johangroth/pluto2/HW/pluto.pdf

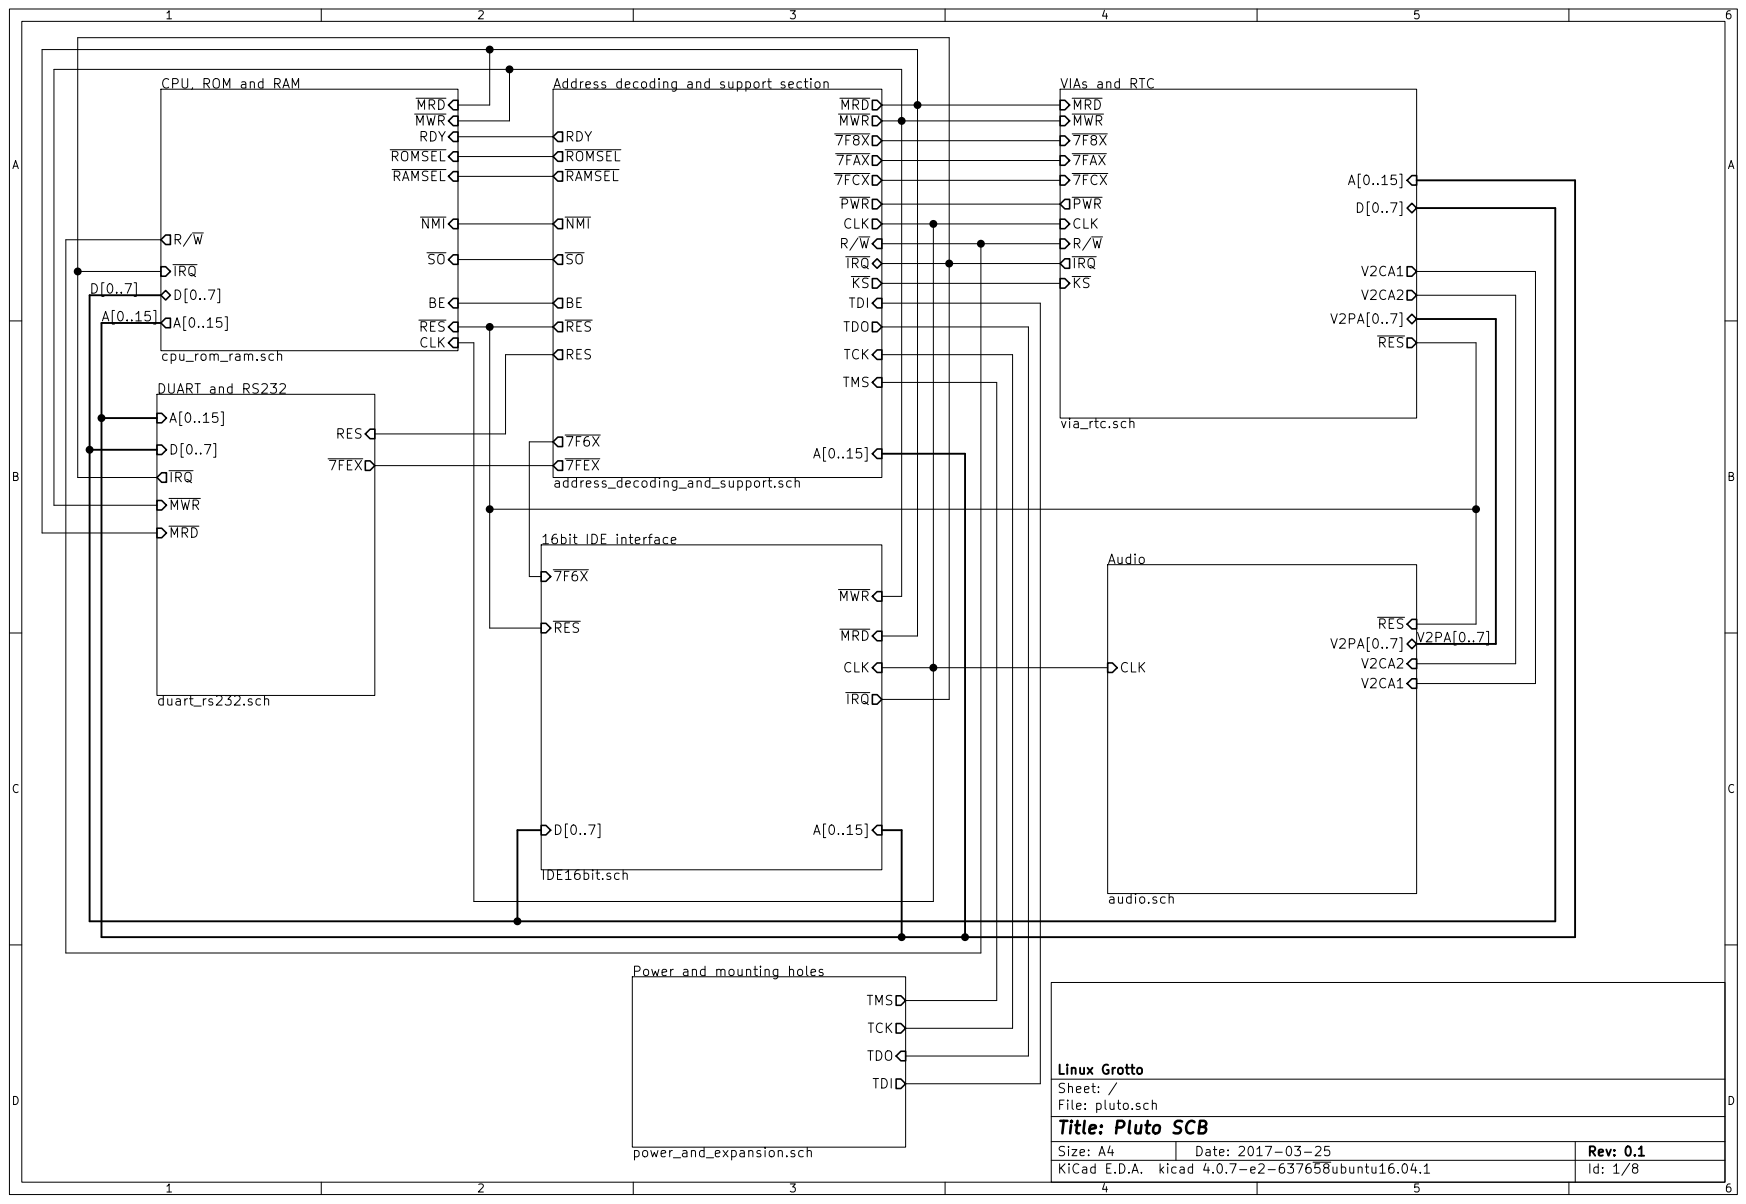
[picture p12: page 1]

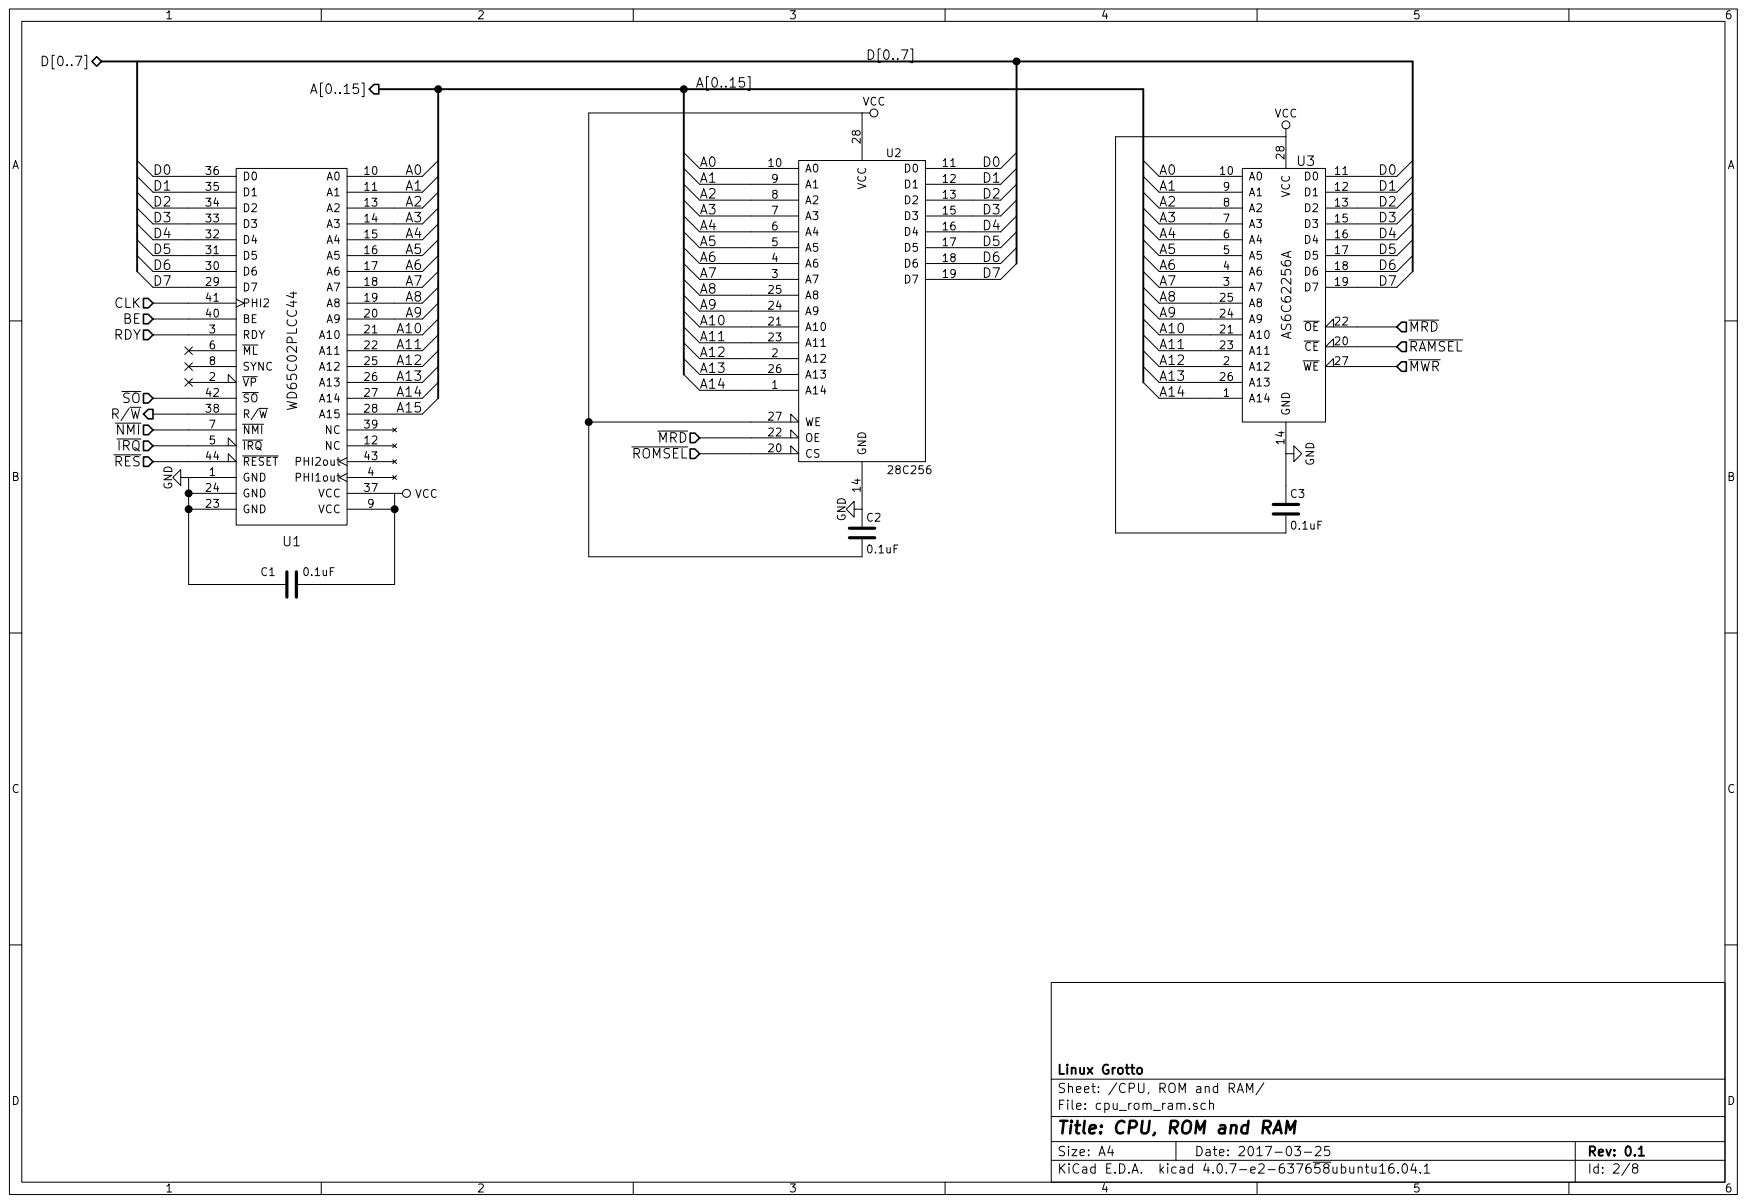
[picture p13: page 2]

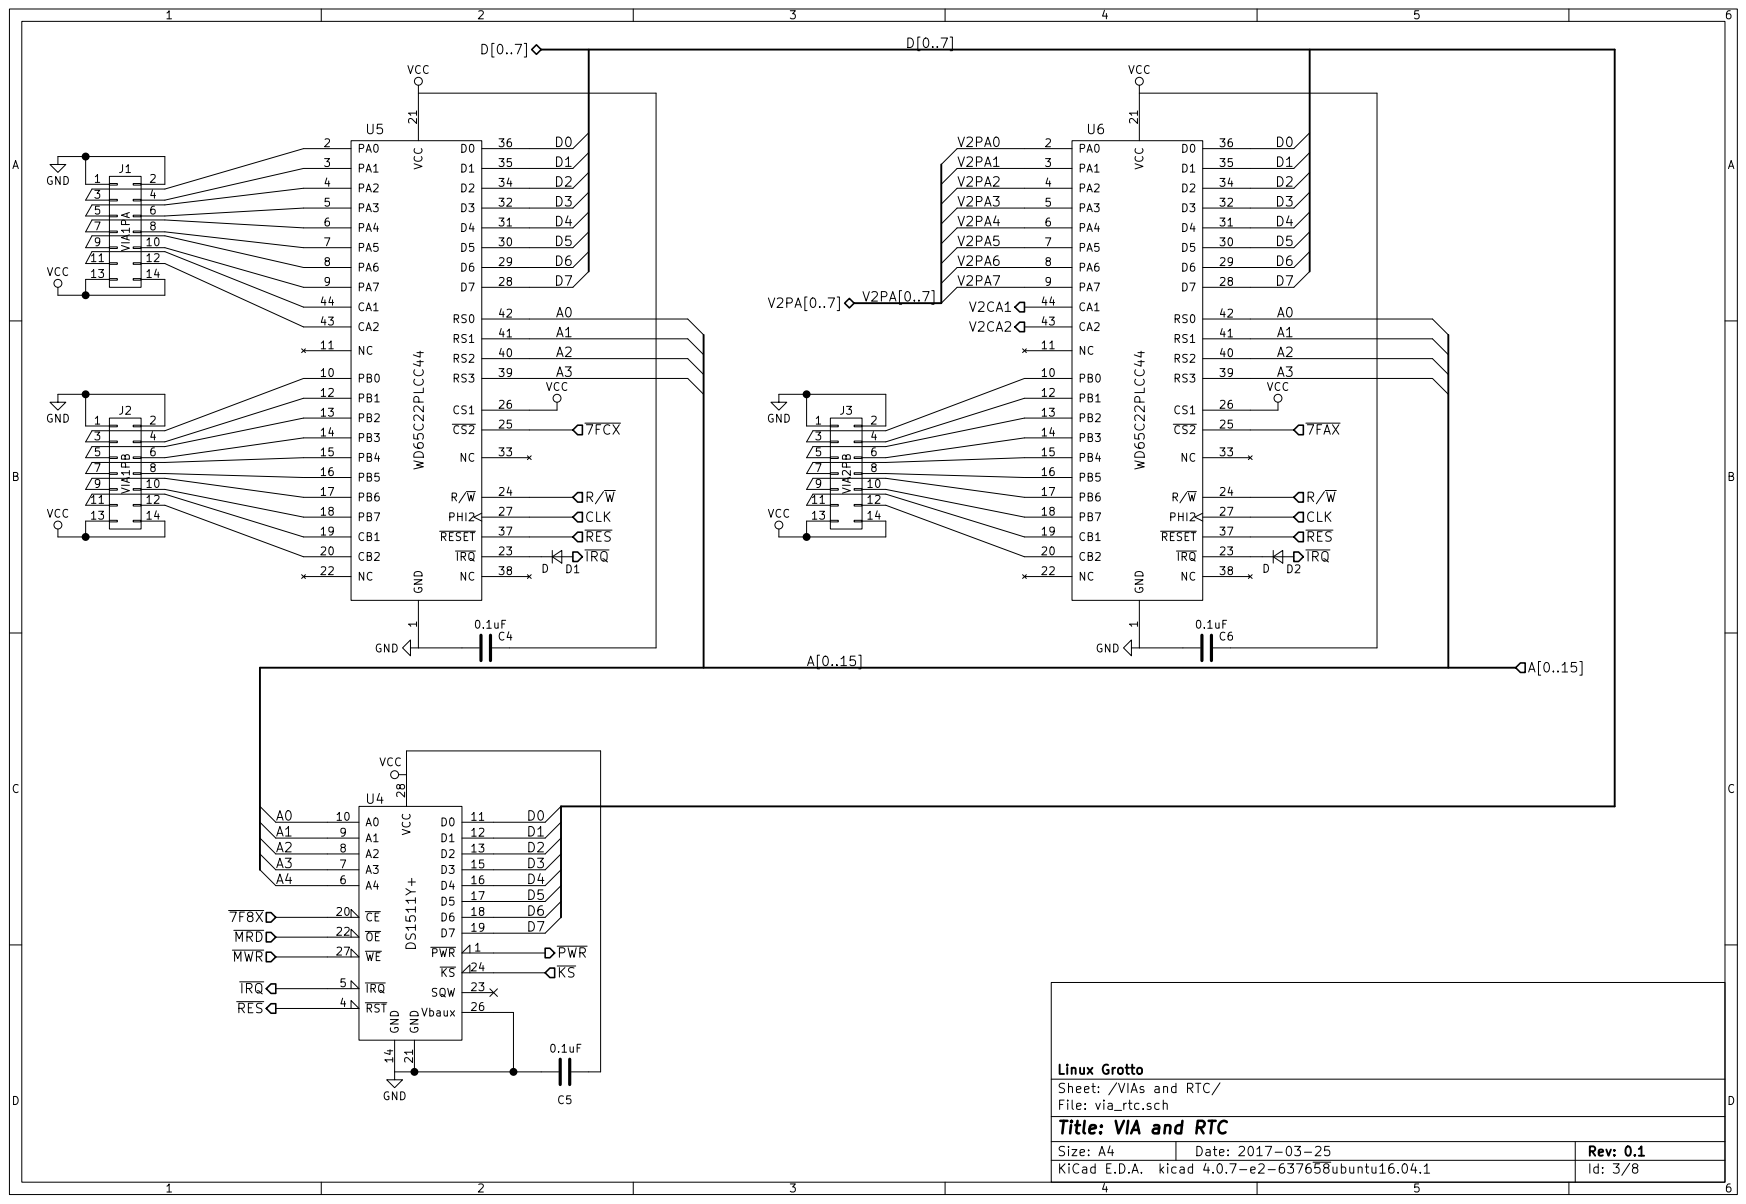
[picture p14: page 3]

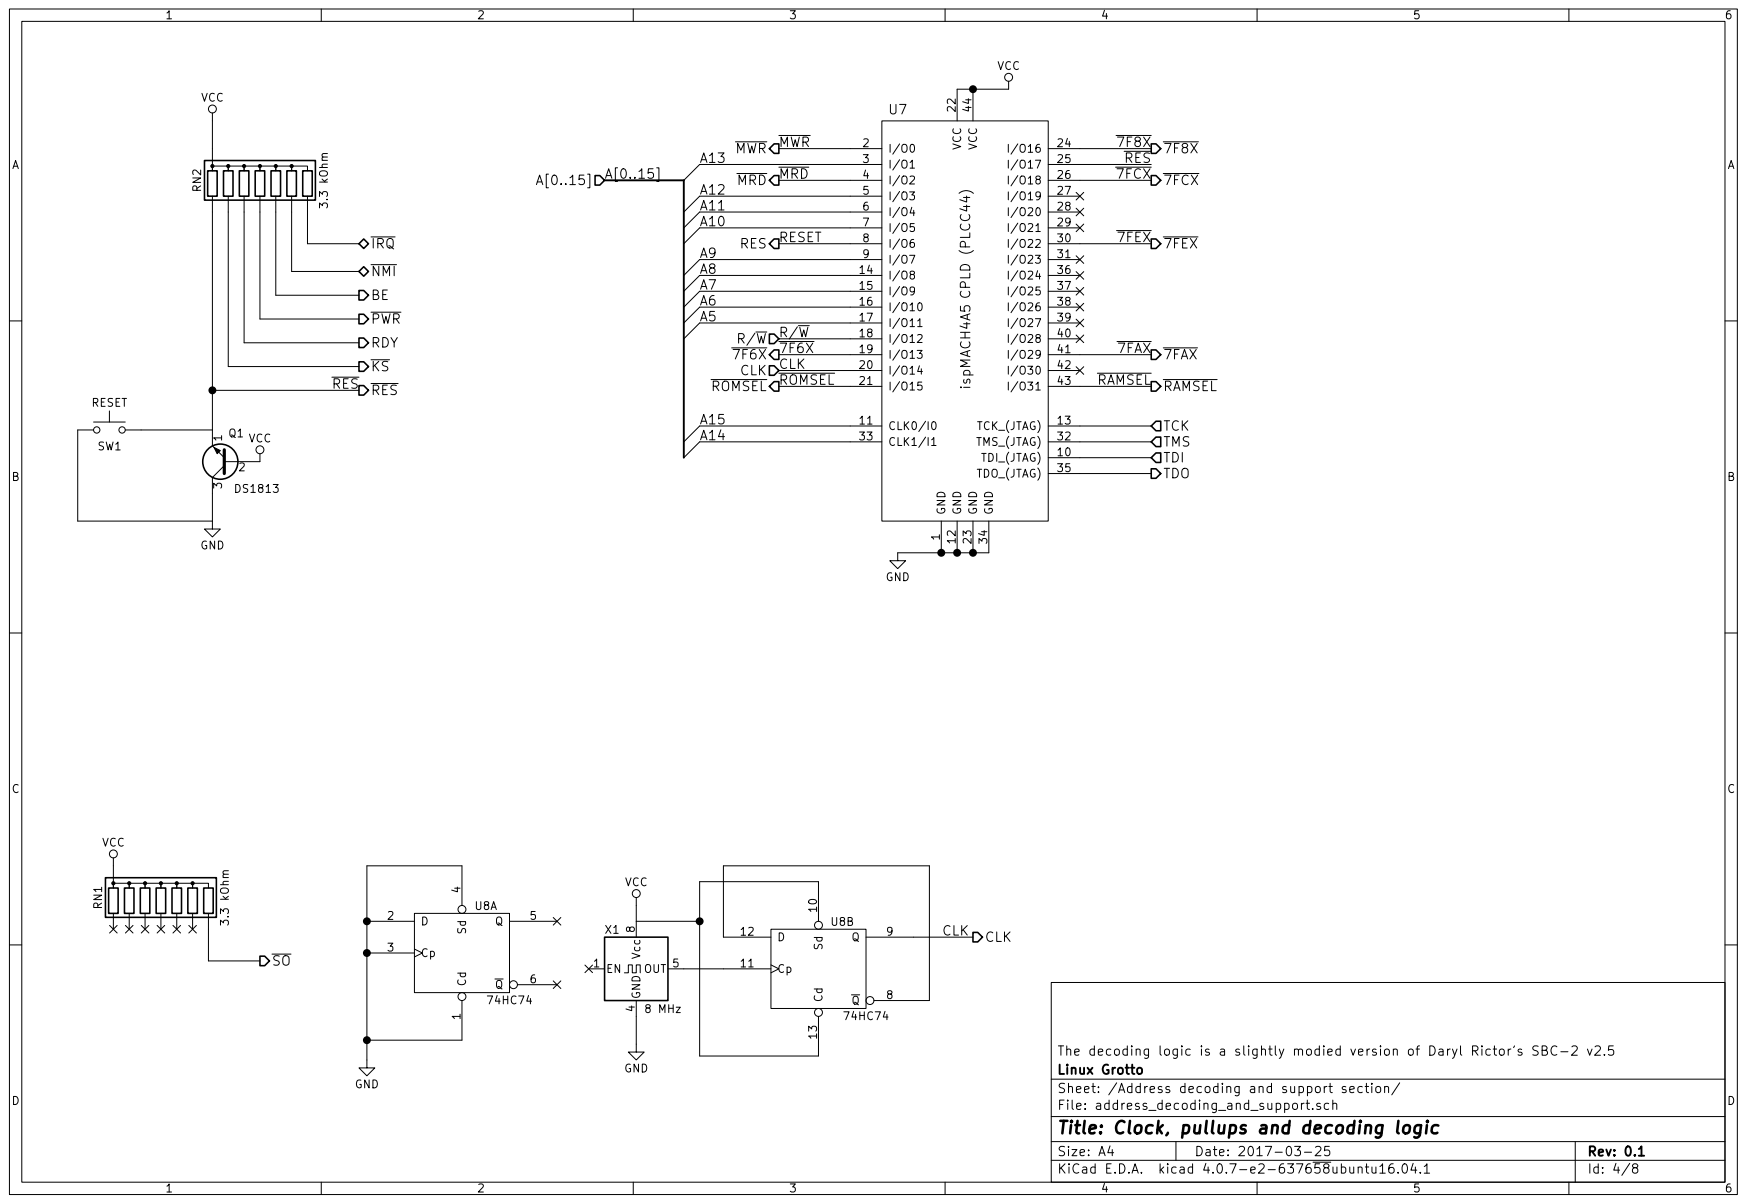
[picture p15: page 4]

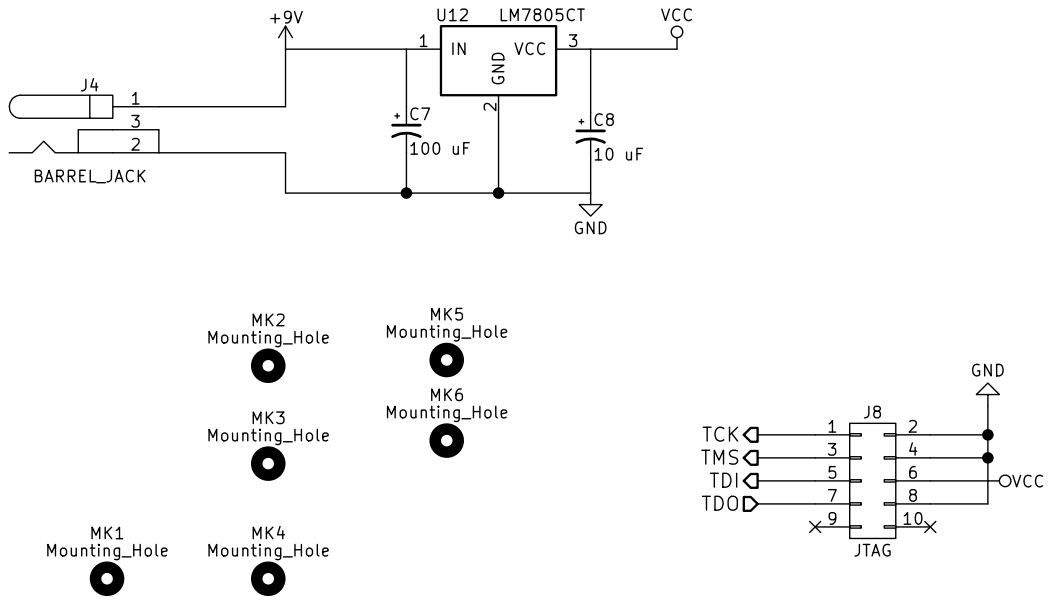
[picture p16: page 5]

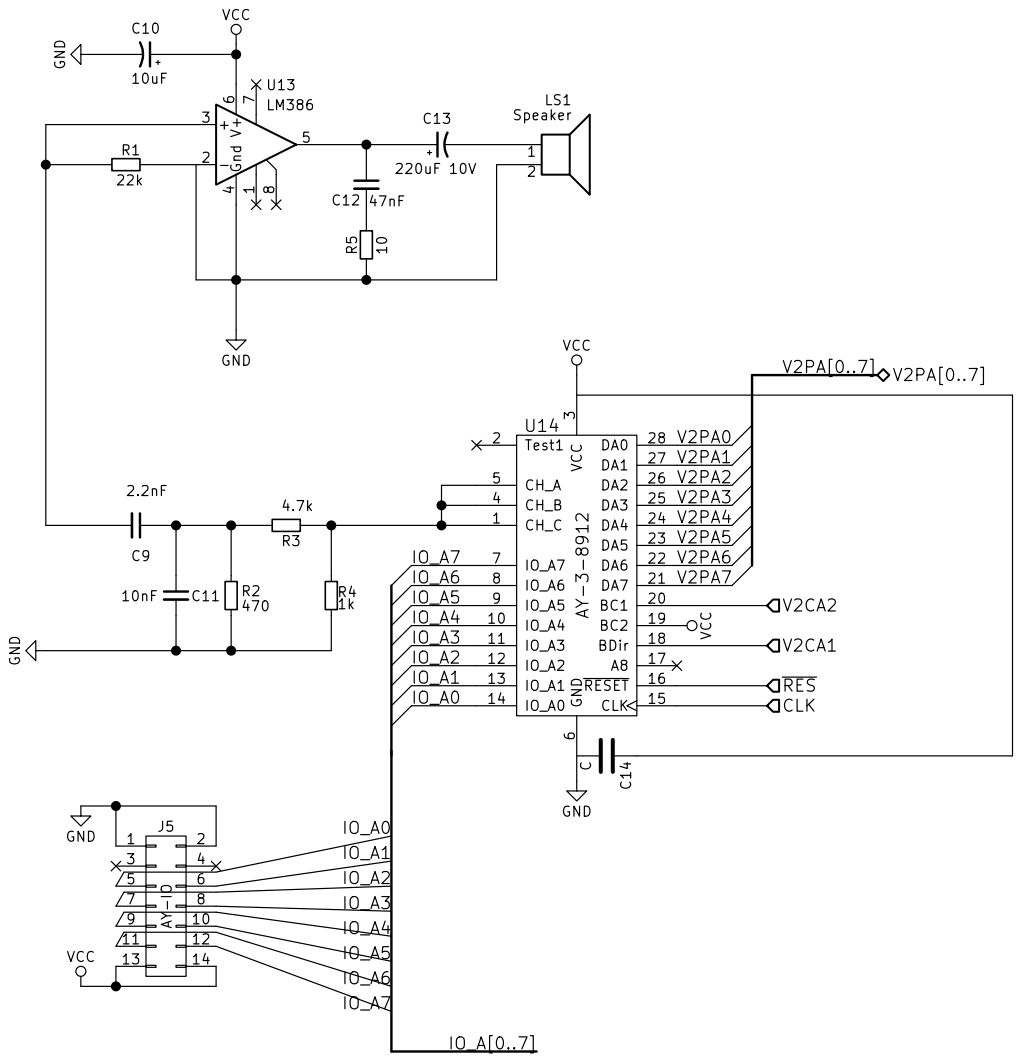
[picture p17: page 6]

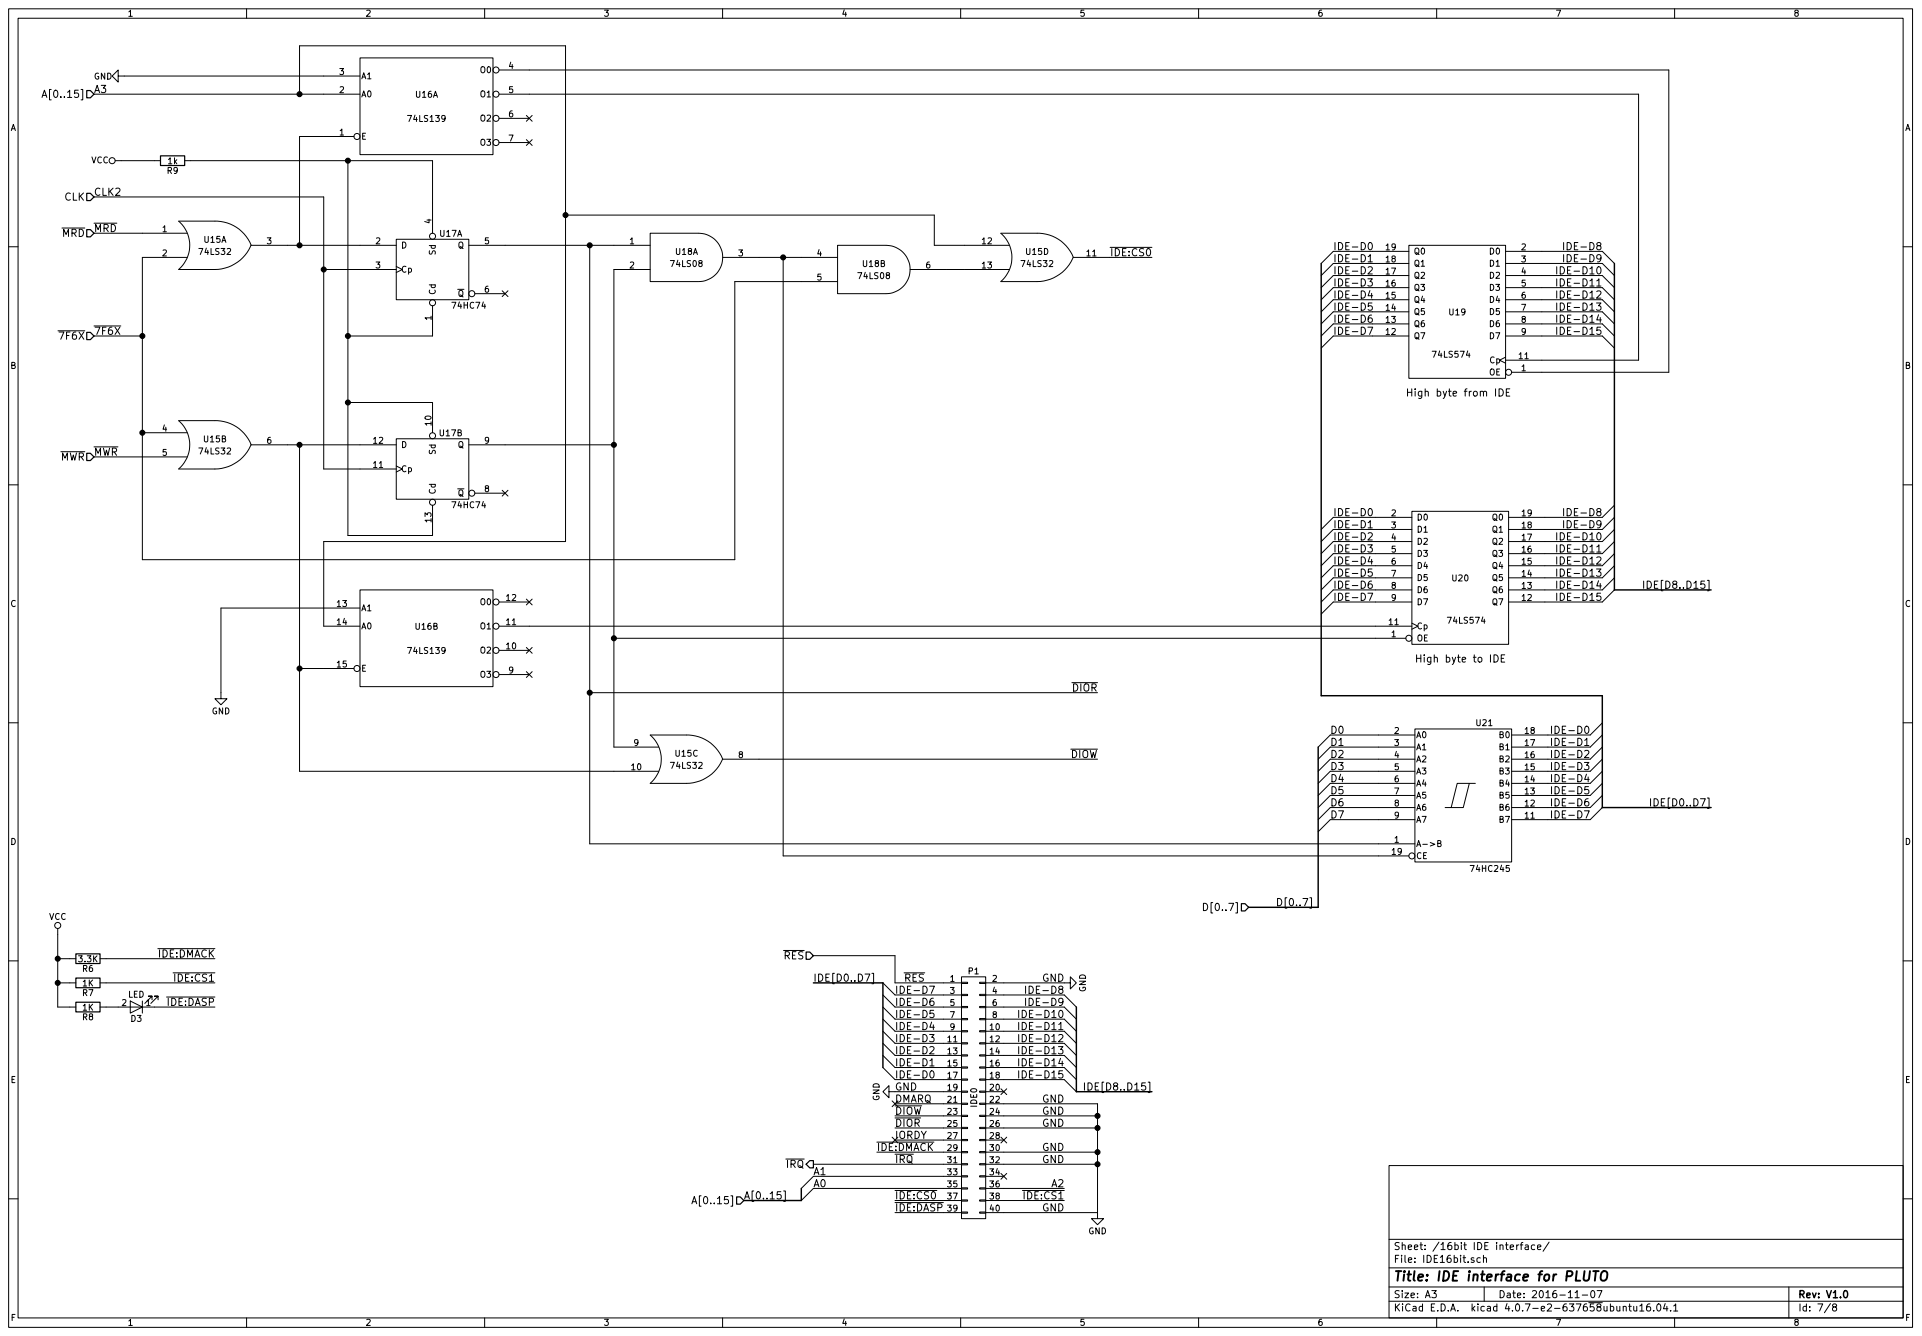
[picture p18: page 7]

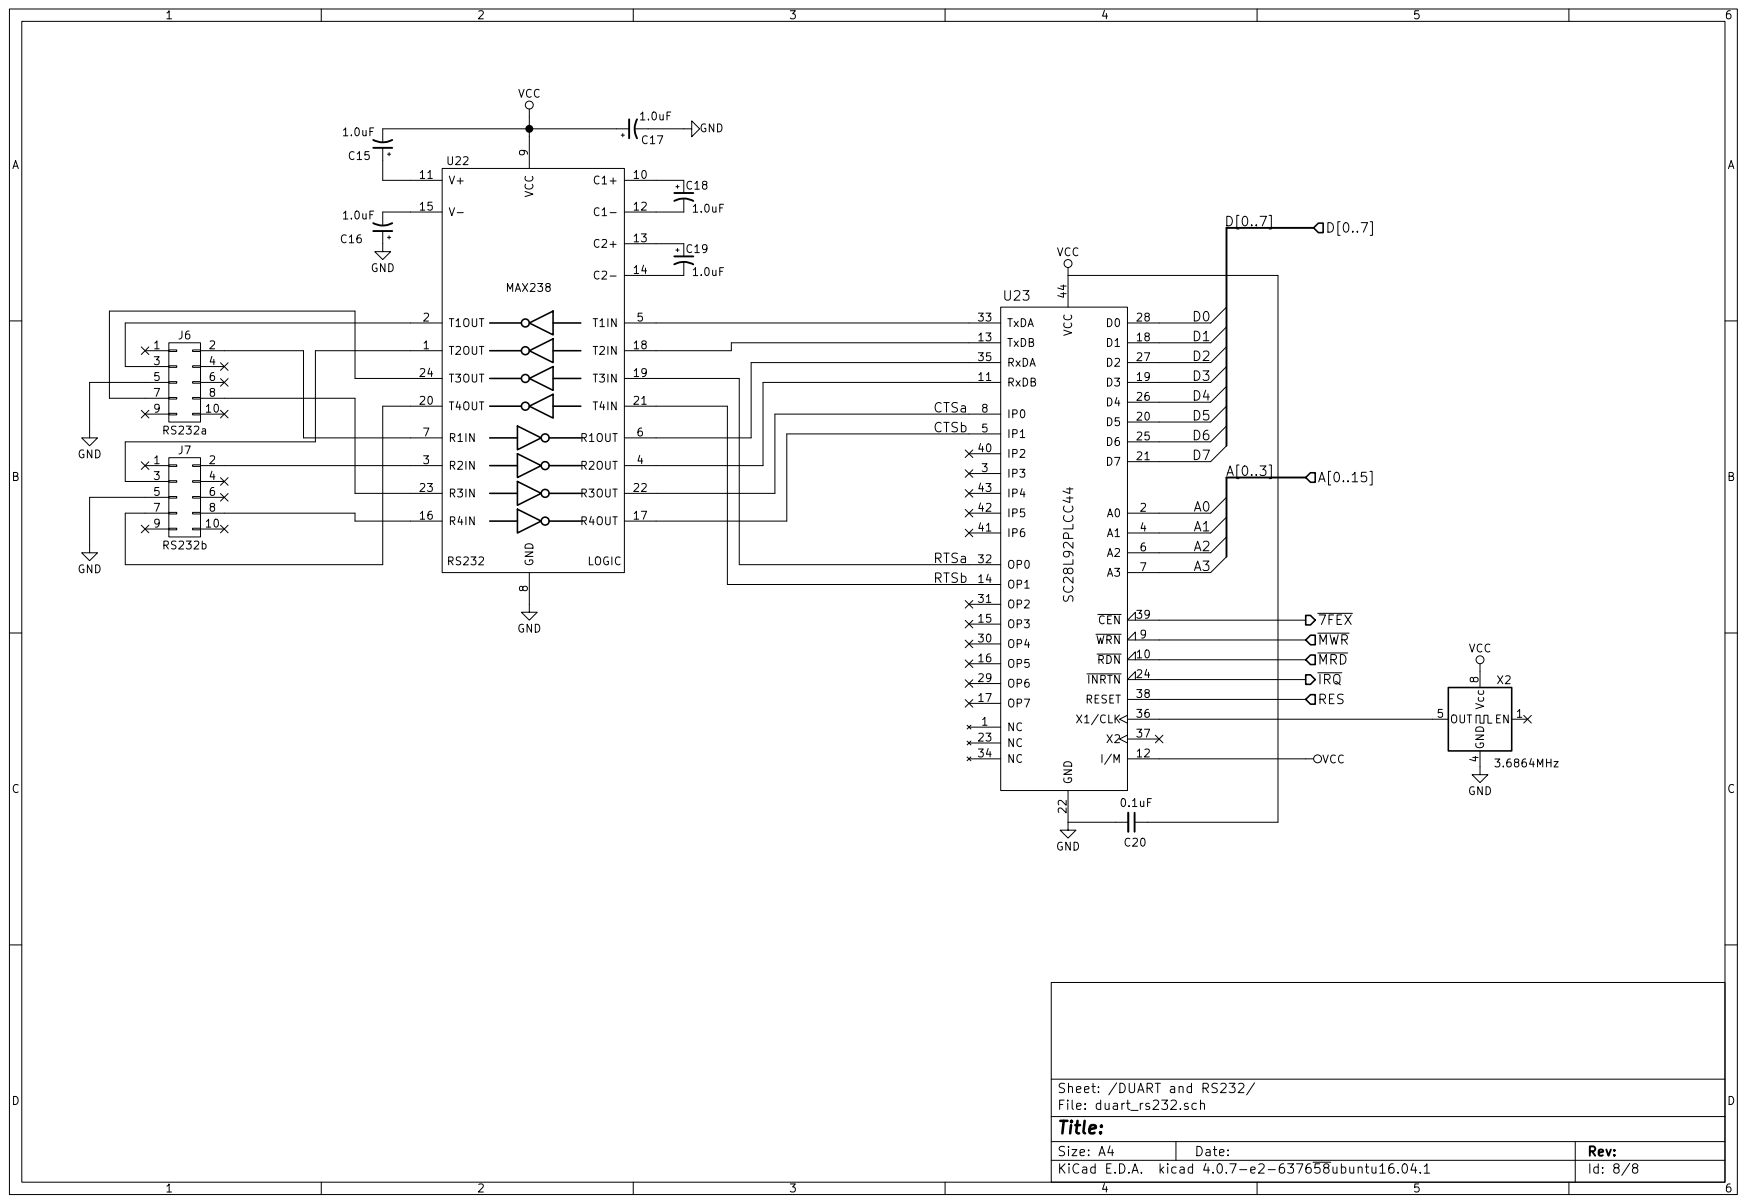
[picture p19: page 8]
