johangroth/pluto2/(list of files, drawings)

Other design files:
HW/pluto.dsn
