johangroth/pluto2/HW/pluto.kicad_pcb

## KiCad design HW/pluto.kicad_pcb (2019-11-03)

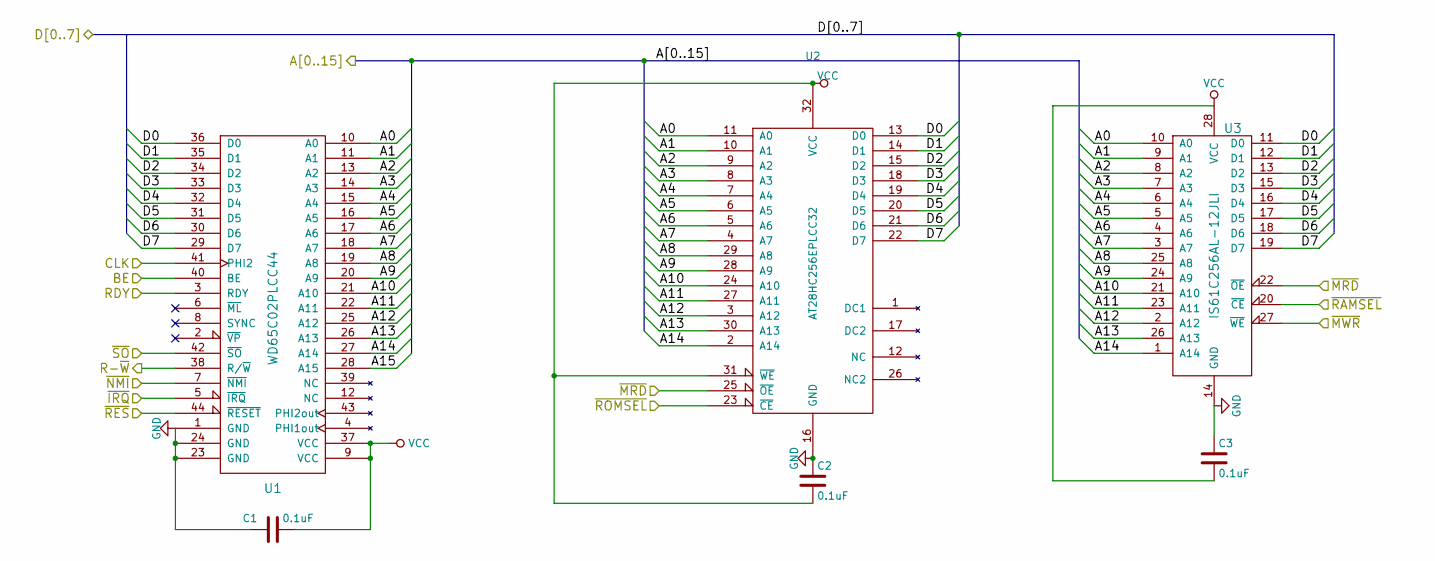
[picture p20: schematic cpu_rom_ram.sch, CPU, ROM and RAM]

Parts:
C1, C2, C3: 0.1uF; C_0805_2012Metric_Pad1.15x1.40mm_HandSolder
U1: WD65C02PLCC44; PLCC-44_THT-Socket
U2: AT28HC256EPLCC32; PLCC-32_THT-Socket
U3: IS61C256AL-12JLI; SOJ-28_7.585x18.12mm_P1.27mm

Connections:
/16bit IDE interface/A0: U1.10 (A0), U2.11 (A0), U3.10 (A0); also elsewhere on the board
/16bit IDE interface/A1: U1.11 (A1), U2.10 (A1), U3.9 (A1); also elsewhere on the board
/16bit IDE interface/A2: U1.13 (A2), U2.9 (A2), U3.8 (A2); also elsewhere on the board
/16bit IDE interface/A3: U1.14 (A3), U2.8 (A3), U3.7 (A3); also elsewhere on the board
/16bit IDE interface/CLK: U1.41 (PHI2); also elsewhere on the board
/16bit IDE interface/D0: U1.36 (D0), U2.13 (D0), U3.11 (D0); also elsewhere on the board
/16bit IDE interface/D1: U1.35 (D1), U2.14 (D1), U3.12 (D1); also elsewhere on the board
/16bit IDE interface/D2: U1.34 (D2), U2.15 (D2), U3.13 (D2); also elsewhere on the board
/16bit IDE interface/D3: U1.33 (D3), U2.18 (D3), U3.15 (D3); also elsewhere on the board
/16bit IDE interface/D4: U1.32 (D4), U2.19 (D4), U3.16 (D4); also elsewhere on the board
/16bit IDE interface/D5: U1.31 (D5), U2.20 (D5), U3.17 (D5); also elsewhere on the board
/16bit IDE interface/D6: U1.30 (D6), U2.21 (D6), U3.18 (D6); also elsewhere on the board
/16bit IDE interface/D7: U1.29 (D7), U2.22 (D7), U3.19 (D7); also elsewhere on the board
/16bit IDE interface/R-~W: U1.38 (R/~W); also elsewhere on the board
/16bit IDE interface/~IRQ: U1.5 (~IRQ); also elsewhere on the board
/16bit IDE interface/~RES: U1.44 (~RESET); also elsewhere on the board
/Address decoding and support section/A5: U1.16 (A5), U2.6 (A5), U3.5 (A5); also elsewhere on the board
/Address decoding and support section/A6: U1.17 (A6), U2.5 (A6), U3.4 (A6); also elsewhere on the board
/Address decoding and support section/A7: U1.18 (A7), U2.4 (A7), U3.3 (A7); also elsewhere on the board
/Address decoding and support section/A8: U1.19 (A8), U2.29 (A8), U3.25 (A8); also elsewhere on the board
/Address decoding and support section/A9: U1.20 (A9), U2.28 (A9), U3.24 (A9); also elsewhere on the board
/Address decoding and support section/A10: U1.21 (A10), U2.24 (A10), U3.21 (A10); also elsewhere on the board
/Address decoding and support section/A11: U1.22 (A11), U2.27 (A11), U3.23 (A11); also elsewhere on the board
/Address decoding and support section/A12: U1.25 (A12), U2.3 (A12), U3.2 (A12); also elsewhere on the board
/Address decoding and support section/A13: U1.26 (A13), U2.30 (A13), U3.26 (A13); also elsewhere on the board
/Address decoding and support section/A14: U1.27 (A14), U2.2 (A14), U3.1 (A14); also elsewhere on the board
/Address decoding and support section/A15: U1.28 (A15); also elsewhere on the board
/Address decoding and support section/BE: U1.40 (BE); also elsewhere on the board
/Address decoding and support section/RDY: U1.3 (RDY); also elsewhere on the board
/Address decoding and support section/~MRD: U2.25 (~OE), U3.22 (~OE); also elsewhere on the board
/Address decoding and support section/~MWR: U3.27 (~WE); also elsewhere on the board
/Address decoding and support section/~NMI: U1.7 (~NMI); also elsewhere on the board
/Address decoding and support section/~RAMSEL: U3.20 (~CE); also elsewhere on the board
/Address decoding and support section/~ROMSEL: U2.23 (~CE); also elsewhere on the board
/Address decoding and support section/~SO: U1.42 (~SO); also elsewhere on the board
/CPU, ROM and RAM/A4: U1.15 (A4), U2.7 (A4), U3.6 (A4); also elsewhere on the board
GND: C1.1, C2.1, C3.1, U1.1 (GND), U1.23 (GND), U1.24 (GND), U2.16 (GND), U3.14 (GND); also elsewhere on the board
VCC: C1.2, C2.2, C3.2, U1.9 (VCC), U1.37 (VCC), U2.31 (~WE), U2.32 (VCC), U3.28 (VCC); also elsewhere on the board

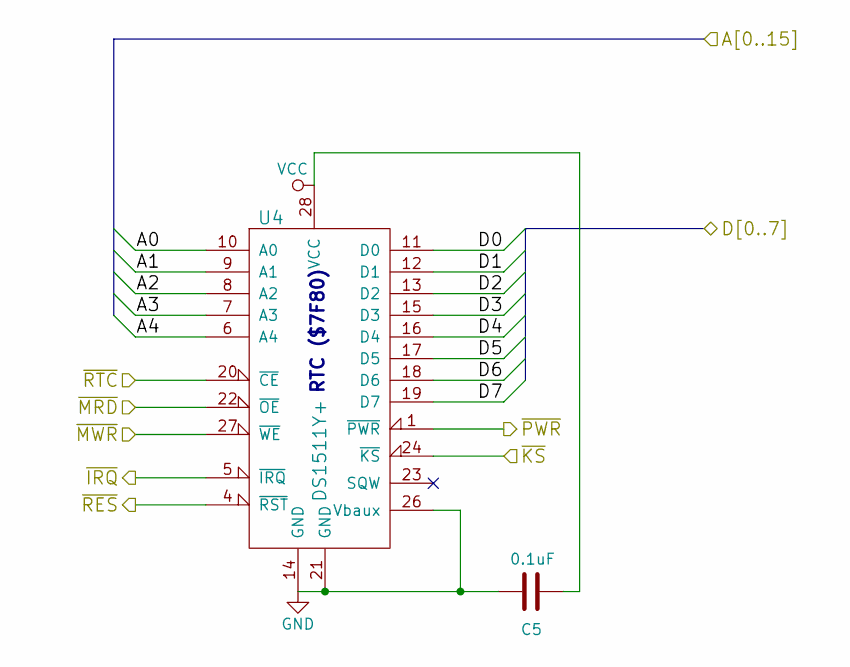
[picture p21: schematic via_rtc.sch, VIA and RTC]

Parts:
C5: 0.1uF; C_0805_2012Metric_Pad1.15x1.40mm_HandSolder
U4: DS1511Y+; DIP-28_W15.24mm_Socket

Connections:
/16bit IDE interface/A0: U4.10 (A0); also elsewhere on the board
/16bit IDE interface/A1: U4.9 (A1); also elsewhere on the board
/16bit IDE interface/A2: U4.8 (A2); also elsewhere on the board
/16bit IDE interface/A3: U4.7 (A3); also elsewhere on the board
/16bit IDE interface/D0: U4.11 (D0); also elsewhere on the board
/16bit IDE interface/D1: U4.12 (D1); also elsewhere on the board
/16bit IDE interface/D2: U4.13 (D2); also elsewhere on the board
/16bit IDE interface/D3: U4.15 (D3); also elsewhere on the board
/16bit IDE interface/D4: U4.16 (D4); also elsewhere on the board
/16bit IDE interface/D5: U4.17 (D5); also elsewhere on the board
/16bit IDE interface/D6: U4.18 (D6); also elsewhere on the board
/16bit IDE interface/D7: U4.19 (D7); also elsewhere on the board
/16bit IDE interface/~IRQ: U4.5 (~IRQ); also elsewhere on the board
/16bit IDE interface/~RES: U4.4 (~RST); also elsewhere on the board
/Address decoding and support section/~KS: U4.24 (~KS); also elsewhere on the board
/Address decoding and support section/~MRD: U4.22 (~OE); also elsewhere on the board
/Address decoding and support section/~MWR: U4.27 (~WE); also elsewhere on the board
/Address decoding and support section/~PWR: U4.1 (~PWR); also elsewhere on the board
/Address decoding and support section/~RTC: U4.20 (~CE); also elsewhere on the board
/CPU, ROM and RAM/A4: U4.6 (A4); also elsewhere on the board
GND: C5.2, U4.14 (GND), U4.21 (GND), U4.26 (Vbaux); also elsewhere on the board
VCC: C5.1, U4.28 (VCC); also elsewhere on the board

Notes on the sheet:
RTC ($7F80)

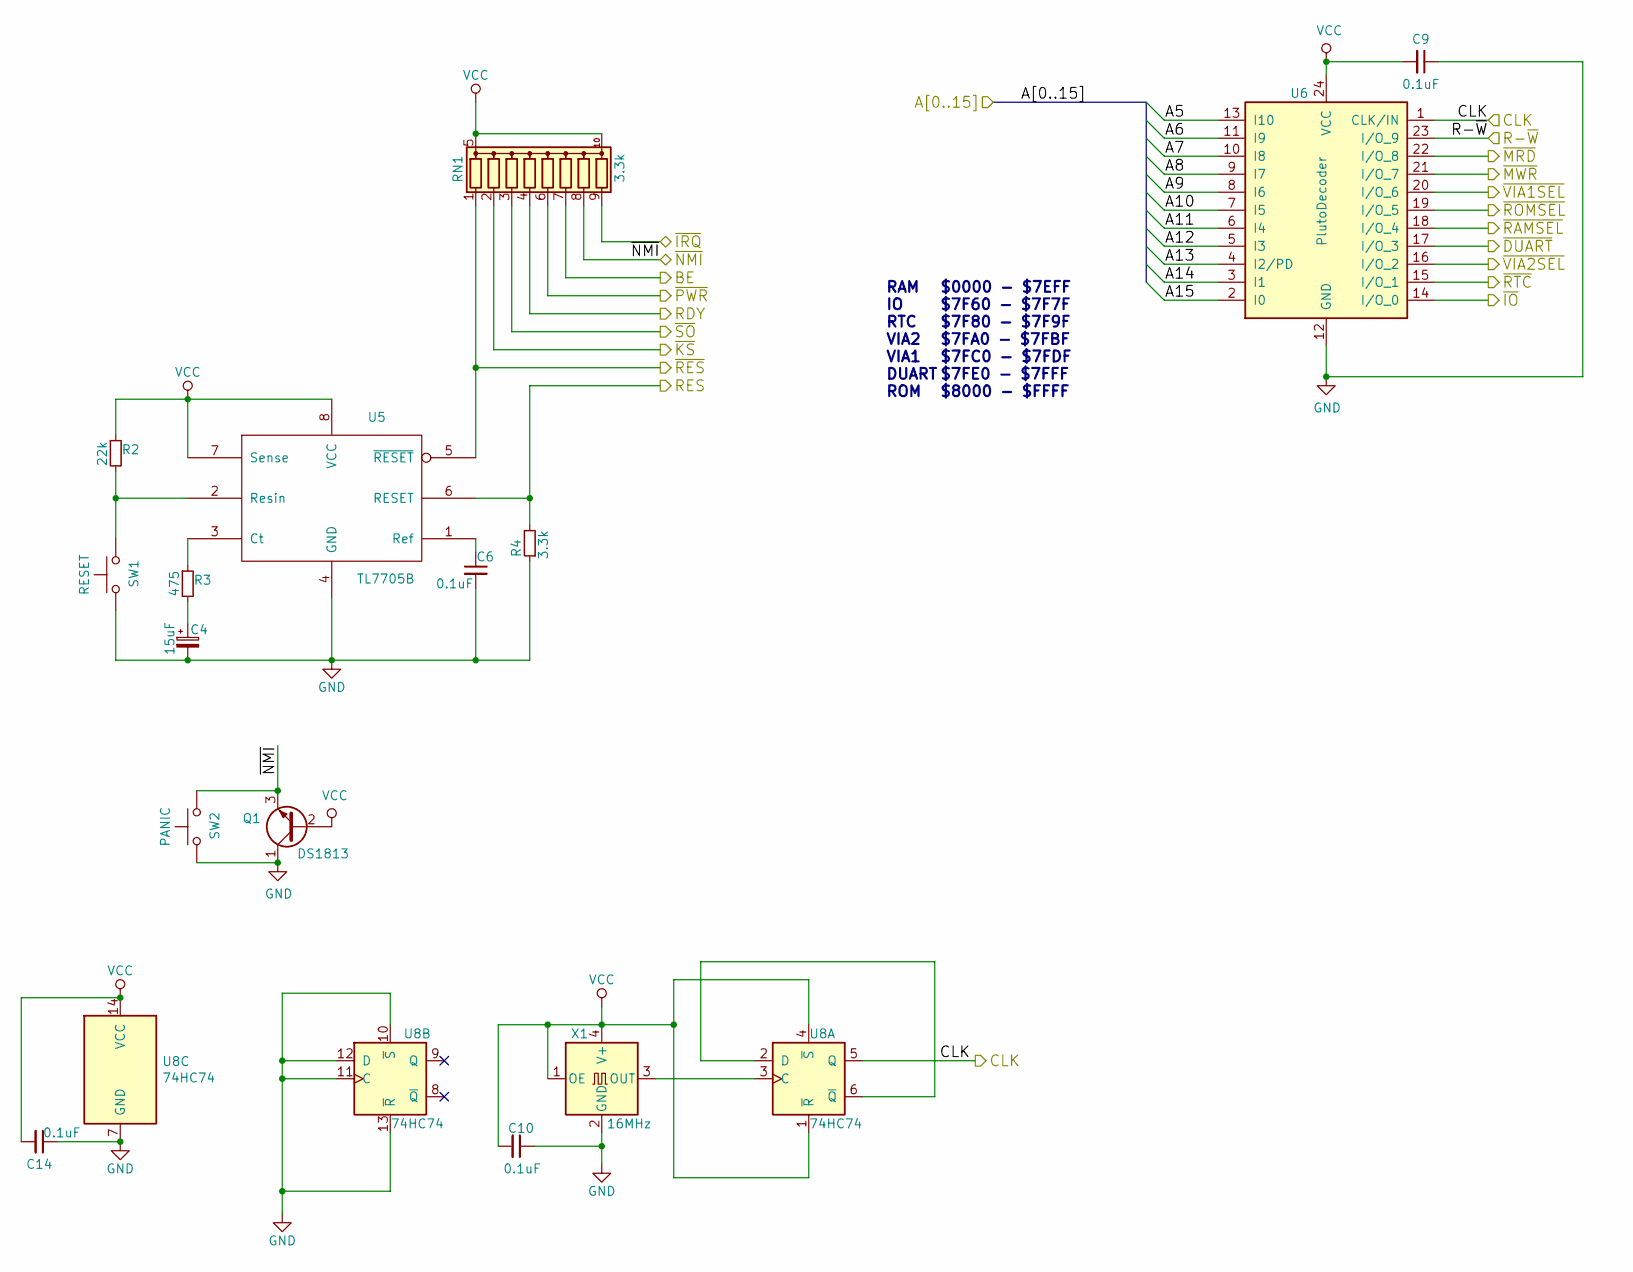
[picture p22: schematic address_decoding_and_support.sch, Clock, pullups and decoding logic]

Parts:
C4: 15uF; CP_EIA-3528-15_AVX-H_Pad1.50x2.35mm_HandSolder
C6, C9, C10, C14: 0.1uF; C_0805_2012Metric_Pad1.15x1.40mm_HandSolder
Q1: DS1813; SOT-23_Handsoldering
R2: 22k; R_1206_3216Metric_Pad1.42x1.75mm_HandSolder
R3: 475; R_1206_3216Metric_Pad1.42x1.75mm_HandSolder
R4: 3.3k; R_1206_3216Metric_Pad1.42x1.75mm_HandSolder
RN1: 3.3k; R_Array_Convex_5x1206
SW1: RESET; SW_PUSH_6mm_H4.3mm
SW2: PANIC; SW_PUSH_6mm_H4.3mm
U5: TL7705B; SOIC-8_3.9x4.9mm_P1.27mm
U6: PlutoDecoder; DIP-24_W7.62mm_Socket
U8: 74HC74; SOIC-14_3.9x8.7mm_P1.27mm
X1: 16MHz; Oscillator_SMD_SeikoEpson_SG8002CA-4Pin_7.0x5.0mm

Connections:
/16bit IDE interface/CLK: U6.1 (CLK/IN), U8.5 (Q); also elsewhere on the board
/16bit IDE interface/R-~W: U6.23 (I/O_9); also elsewhere on the board
/16bit IDE interface/~IRQ: RN1.9 (R8); also elsewhere on the board
/16bit IDE interface/~RES: RN1.1 (R1), U5.5 (~RESET); also elsewhere on the board
/16bit IDE interface/~VIA1SEL: U6.20 (I/O_6); also elsewhere on the board
/16bit IDE interface/~VIA2SEL: U6.16 (I/O_2); also elsewhere on the board
/Address decoding and support section/A5: U6.13 (I10); also elsewhere on the board
/Address decoding and support section/A6: U6.11 (I9); also elsewhere on the board
/Address decoding and support section/A7: U6.10 (I8); also elsewhere on the board
/Address decoding and support section/A8: U6.9 (I7); also elsewhere on the board
/Address decoding and support section/A9: U6.8 (I6); also elsewhere on the board
/Address decoding and support section/A10: U6.7 (I5); also elsewhere on the board
/Address decoding and support section/A11: U6.6 (I4); also elsewhere on the board
/Address decoding and support section/A12: U6.5 (I3); also elsewhere on the board
/Address decoding and support section/A13: U6.4 (I2/PD); also elsewhere on the board
/Address decoding and support section/A14: U6.3 (I1); also elsewhere on the board
/Address decoding and support section/A15: U6.2 (I0); also elsewhere on the board
/Address decoding and support section/BE: RN1.7 (R6); also elsewhere on the board
/Address decoding and support section/RDY: RN1.4 (R4); also elsewhere on the board
/Address decoding and support section/RES: R4.2, U5.6 (RESET); also elsewhere on the board
/Address decoding and support section/~DUART: U6.17 (I/O_3); also elsewhere on the board
/Address decoding and support section/~IO: U6.14 (I/O_0); also elsewhere on the board
/Address decoding and support section/~KS: RN1.2 (R2); also elsewhere on the board
/Address decoding and support section/~MRD: U6.22 (I/O_8); also elsewhere on the board
/Address decoding and support section/~MWR: U6.21 (I/O_7); also elsewhere on the board
/Address decoding and support section/~NMI: Q1.3 (E), RN1.8 (R7), SW2.2; also elsewhere on the board
/Address decoding and support section/~PWR: RN1.6 (R5); also elsewhere on the board
/Address decoding and support section/~RAMSEL: U6.18 (I/O_4); also elsewhere on the board
/Address decoding and support section/~ROMSEL: U6.19 (I/O_5); also elsewhere on the board
/Address decoding and support section/~RTC: U6.15 (I/O_1); also elsewhere on the board
/Address decoding and support section/~SO: RN1.3 (R3); also elsewhere on the board
GND: C4.2, C6.2, C9.1, C10.1, C14.1, Q1.1 (C), R4.1, SW1.1, SW2.1, U5.4 (GND), U6.12 (GND), U8.7 (GND), U8.10 (~S), U8.11 (C), U8.12 (D), U8.13 (~R), X1.2 (GND); also elsewhere on the board
unnamed: C4.1, R3.2
unnamed: C6.1, U5.1 (Ref)
unnamed: R2.2, SW1.2, U5.2 (Resin)
unnamed: R3.1, U5.3 (Ct)
unnamed: U8.2 (D), U8.6 (~Q)
unnamed: U8.3 (C), X1.3 (OUT)
VCC: C9.2, C10.2, C14.2, Q1.2 (B), R2.1, RN1.5 (common), RN1.10 (common), U5.7 (Sense), U5.8 (VCC), U6.24 (VCC), U8.1 (~R), U8.4 (~S), U8.14 (VCC), X1.1 (OE), X1.4 (V+); also elsewhere on the board

Notes on the sheet:
RAM IO RTC VIA2 VIA1 DUART ROM
$0000 - $7EFF $7F60 - $7F7F $7F80 - $7F9F $7FA0 - $7FBF $7FC0 - $7FDF $7FE0 - $7FFF $8000 - $FFFF

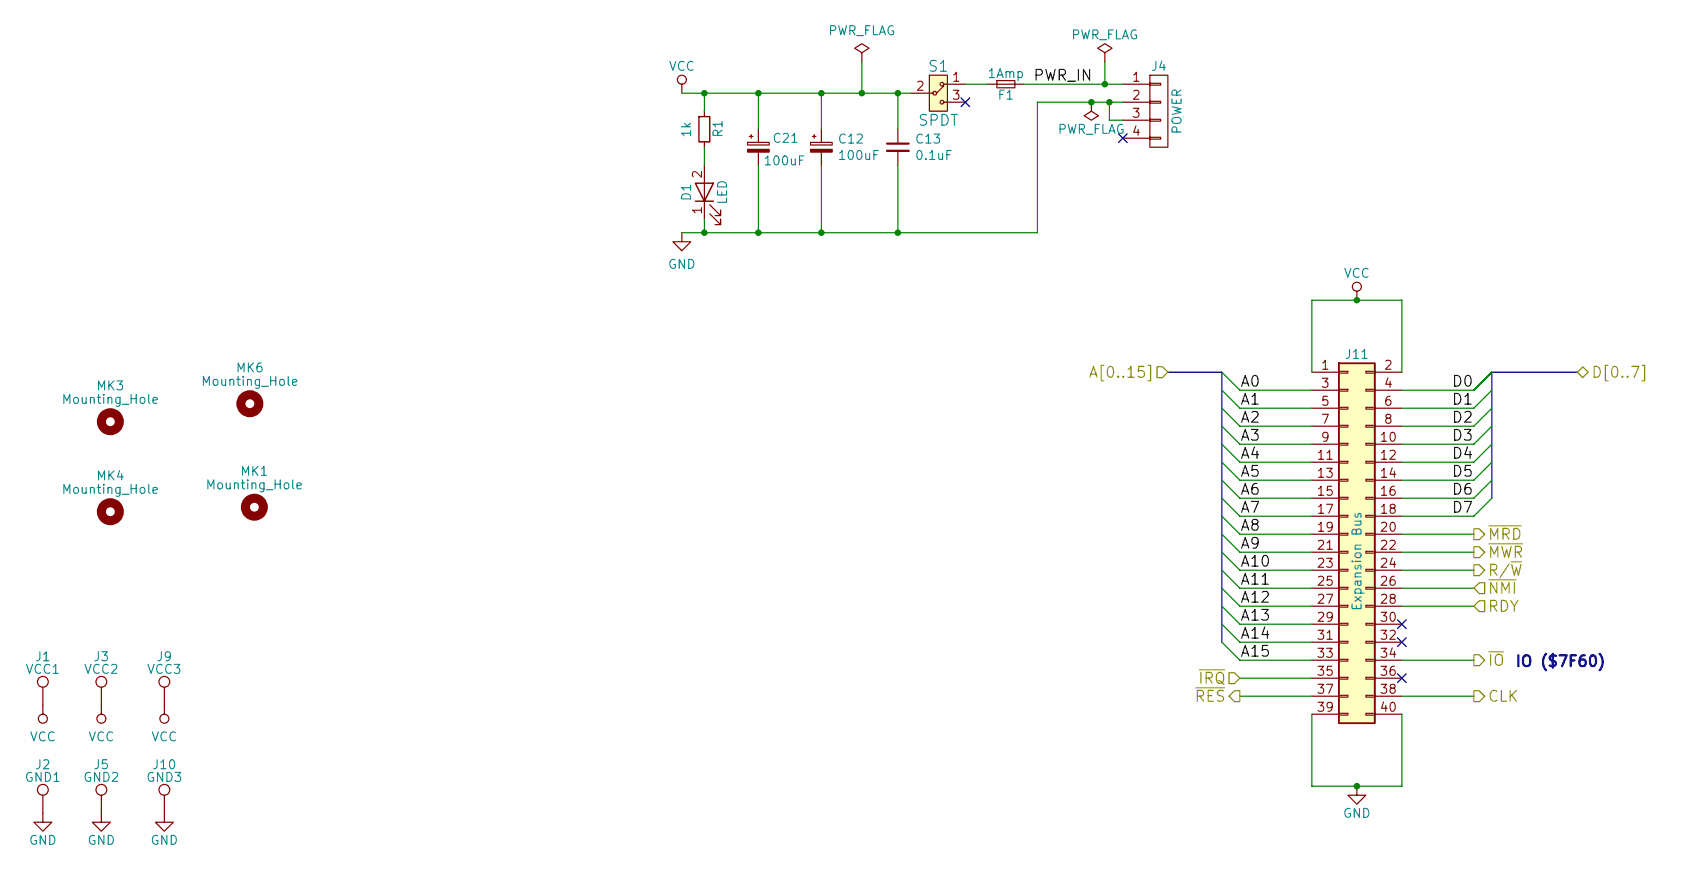
[picture p23: schematic power_and_expansion.sch, Power supply and mounting holes]

Parts:
C12, C21: 100uF; CP_EIA-3528-15_AVX-H_Pad1.50x2.35mm_HandSolder
C13: 0.1uF; C_0805_2012Metric_Pad1.15x1.40mm_HandSolder
D1: LED; LED_D3.0mm
F1: 1Amp; FUSE_0154004.DR
J1: VCC1; PinHeader_1x01_P2.54mm_Vertical
J2: GND1; PinHeader_1x01_P2.54mm_Vertical
J3: VCC2; PinHeader_1x01_P2.54mm_Vertical
J4: POWER; Molex_Nano-Fit_105313-xx04_1x04_P2.50mm_Horizontal
J5: GND2; PinHeader_1x01_P2.54mm_Vertical
J9: VCC3; PinHeader_1x01_P2.54mm_Vertical
J10: GND3; PinHeader_1x01_P2.54mm_Vertical
J11: Expansion Bus; IDC-Header_2x20_P2.54mm_Vertical
MK1, MK3, MK4, MK6: Mounting_Hole; MountingHole_3.2mm_M3_Pad
R1: 1k; R_1206_3216Metric_Pad1.42x1.75mm_HandSolder
S1: SPDT; SW-SPDT-0900766b81587629

Connections:
/16bit IDE interface/A0: J11.3; also elsewhere on the board
/16bit IDE interface/A1: J11.5; also elsewhere on the board
/16bit IDE interface/A2: J11.7; also elsewhere on the board
/16bit IDE interface/A3: J11.9; also elsewhere on the board
/16bit IDE interface/CLK: J11.38; also elsewhere on the board
/16bit IDE interface/D0: J11.4; also elsewhere on the board
/16bit IDE interface/D1: J11.6; also elsewhere on the board
/16bit IDE interface/D2: J11.8; also elsewhere on the board
/16bit IDE interface/D3: J11.10; also elsewhere on the board
/16bit IDE interface/D4: J11.12; also elsewhere on the board
/16bit IDE interface/D5: J11.14; also elsewhere on the board
/16bit IDE interface/D6: J11.16; also elsewhere on the board
/16bit IDE interface/D7: J11.18; also elsewhere on the board
/16bit IDE interface/R-~W: J11.24; also elsewhere on the board
/16bit IDE interface/~IRQ: J11.35; also elsewhere on the board
/16bit IDE interface/~RES: J11.37; also elsewhere on the board
/Address decoding and support section/A5: J11.13; also elsewhere on the board
/Address decoding and support section/A6: J11.15; also elsewhere on the board
/Address decoding and support section/A7: J11.17; also elsewhere on the board
/Address decoding and support section/A8: J11.19; also elsewhere on the board
/Address decoding and support section/A9: J11.21; also elsewhere on the board
/Address decoding and support section/A10: J11.23; also elsewhere on the board
/Address decoding and support section/A11: J11.25; also elsewhere on the board
/Address decoding and support section/A12: J11.27; also elsewhere on the board
/Address decoding and support section/A13: J11.29; also elsewhere on the board
/Address decoding and support section/A14: J11.31; also elsewhere on the board
/Address decoding and support section/A15: J11.33; also elsewhere on the board
/Address decoding and support section/RDY: J11.28; also elsewhere on the board
/Address decoding and support section/~IO: J11.34; also elsewhere on the board
/Address decoding and support section/~MRD: J11.20; also elsewhere on the board
/Address decoding and support section/~MWR: J11.22; also elsewhere on the board
/Address decoding and support section/~NMI: J11.26; also elsewhere on the board
/CPU, ROM and RAM/A4: J11.11; also elsewhere on the board
/Power and mounting holes/PWR_IN: F1.2, J4.1
GND: C12.2, C13.2, C21.2, D1.1 (K), J2.1, J4.2, J4.3, J5.1, J10.1, J11.39, J11.40; also elsewhere on the board
unnamed: D1.2 (A), R1.2
unnamed: F1.1, S1.1
VCC: C12.1, C13.1, C21.1, J1.1, J3.1, J9.1, J11.1, J11.2, R1.1, S1.2 (COM); also elsewhere on the board

Notes on the sheet:
IO ($7F60)

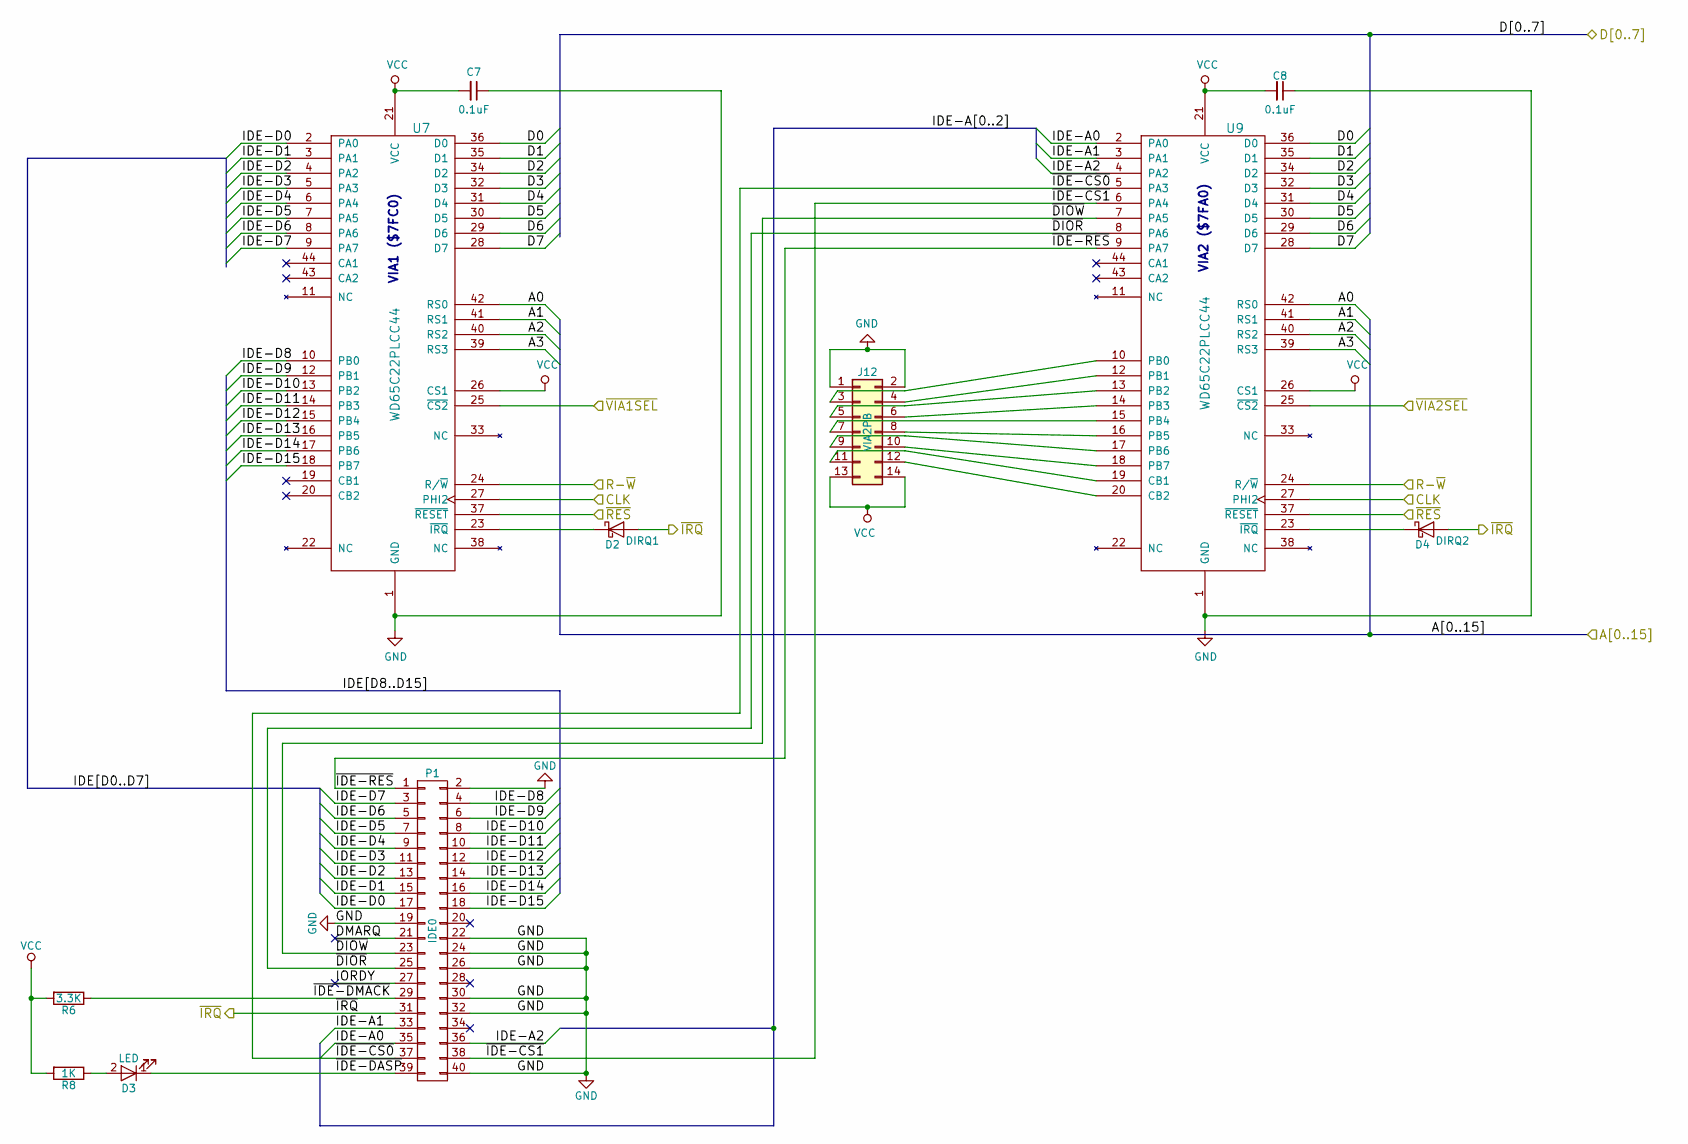
[picture p24: schematic IDE16bit.sch, IDE interface for PLUTO]

Parts:
C7, C8: 0.1uF; C_0805_2012Metric_Pad1.15x1.40mm_HandSolder
D2: DIRQ1; D_SOD-323_HandSoldering
D3: LED; LED_D3.0mm
D4: DIRQ2; D_SOD-323_HandSoldering
J12: VIA2PB; IDC-Header_2x07_P2.54mm_Vertical
P1: IDE0; IDC-Header_2x20_P2.54mm_Vertical
R6: 3.3K; R_1206_3216Metric_Pad1.42x1.75mm_HandSolder
R8: 1K; R_1206_3216Metric_Pad1.42x1.75mm_HandSolder
U7, U9: WD65C22PLCC44; PLCC-44_THT-Socket

Connections:
/16bit IDE interface/A0: U7.42 (RS0), U9.42 (RS0); also elsewhere on the board
/16bit IDE interface/A1: U7.41 (RS1), U9.41 (RS1); also elsewhere on the board
/16bit IDE interface/A2: U7.40 (RS2), U9.40 (RS2); also elsewhere on the board
/16bit IDE interface/A3: U7.39 (RS3), U9.39 (RS3); also elsewhere on the board
/16bit IDE interface/CLK: U7.27 (PHI2), U9.27 (PHI2); also elsewhere on the board
/16bit IDE interface/D0: U7.36 (D0), U9.36 (D0); also elsewhere on the board
/16bit IDE interface/D1: U7.35 (D1), U9.35 (D1); also elsewhere on the board
/16bit IDE interface/D2: U7.34 (D2), U9.34 (D2); also elsewhere on the board
/16bit IDE interface/D3: U7.32 (D3), U9.32 (D3); also elsewhere on the board
/16bit IDE interface/D4: U7.31 (D4), U9.31 (D4); also elsewhere on the board
/16bit IDE interface/D5: U7.30 (D5), U9.30 (D5); also elsewhere on the board
/16bit IDE interface/D6: U7.29 (D6), U9.29 (D6); also elsewhere on the board
/16bit IDE interface/D7: U7.28 (D7), U9.28 (D7); also elsewhere on the board
/16bit IDE interface/DMARQ: P1.21
/16bit IDE interface/IDE-A0: P1.35, U9.2 (PA0)
/16bit IDE interface/IDE-A1: P1.33, U9.3 (PA1)
/16bit IDE interface/IDE-A2: P1.36, U9.4 (PA2)
/16bit IDE interface/IDE-D0: P1.17, U7.2 (PA0)
/16bit IDE interface/IDE-D1: P1.15, U7.3 (PA1)
/16bit IDE interface/IDE-D2: P1.13, U7.4 (PA2)
/16bit IDE interface/IDE-D3: P1.11, U7.5 (PA3)
/16bit IDE interface/IDE-D4: P1.9, U7.6 (PA4)
/16bit IDE interface/IDE-D5: P1.7, U7.7 (PA5)
/16bit IDE interface/IDE-D6: P1.5, U7.8 (PA6)
/16bit IDE interface/IDE-D7: P1.3, U7.9 (PA7)
/16bit IDE interface/IDE-D8: P1.4, U7.10 (PB0)
/16bit IDE interface/IDE-D9: P1.6, U7.12 (PB1)
/16bit IDE interface/IDE-D10: P1.8, U7.13 (PB2)
/16bit IDE interface/IDE-D11: P1.10, U7.14 (PB3)
/16bit IDE interface/IDE-D12: P1.12, U7.15 (PB4)
/16bit IDE interface/IDE-D13: P1.14, U7.16 (PB5)
/16bit IDE interface/IDE-D14: P1.16, U7.17 (PB6)
/16bit IDE interface/IDE-D15: P1.18, U7.18 (PB7)
/16bit IDE interface/IORDY: P1.27
/16bit IDE interface/R-~W: U7.24 (R/~W), U9.24 (R/~W); also elsewhere on the board
/16bit IDE interface/~DIOR: P1.25, U9.8 (PA6)
/16bit IDE interface/~DIOW: P1.23, U9.7 (PA5)
/16bit IDE interface/~IDE-CS0: P1.37, U9.5 (PA3)
/16bit IDE interface/~IDE-CS1: P1.38, U9.6 (PA4)
/16bit IDE interface/~IDE-DASP: D3.1 (K), P1.39
/16bit IDE interface/~IDE-DMACK: P1.29, R6.1
/16bit IDE interface/~IDE-RES: P1.1, U9.9 (PA7)
/16bit IDE interface/~IRQ: D2.2 (A), D4.2 (A), P1.31; also elsewhere on the board
/16bit IDE interface/~RES: U7.37 (~RESET), U9.37 (~RESET); also elsewhere on the board
/16bit IDE interface/~VIA1SEL: U7.25 (~CS2); also elsewhere on the board
/16bit IDE interface/~VIA2SEL: U9.25 (~CS2); also elsewhere on the board
GND: C7.1, C8.1, J12.1, J12.2, P1.2, P1.19, P1.22, P1.24, P1.26, P1.30, P1.32, P1.40, U7.1 (GND), U9.1 (GND); also elsewhere on the board
unnamed: D2.1 (K), U7.23 (~IRQ)
unnamed: D3.2 (A), R8.1
unnamed: D4.1 (K), U9.23 (~IRQ)
unnamed: J12.3, U9.10 (PB0)
unnamed: J12.4, U9.12 (PB1)
unnamed: J12.5, U9.13 (PB2)
unnamed: J12.6, U9.14 (PB3)
unnamed: J12.7, U9.15 (PB4)
unnamed: J12.8, U9.16 (PB5)
unnamed: J12.9, U9.17 (PB6)
unnamed: J12.10, U9.18 (PB7)
unnamed: J12.11, U9.19 (CB1)
unnamed: J12.12, U9.20 (CB2)
VCC: C7.2, C8.2, J12.13, J12.14, R6.2, R8.2, U7.21 (VCC), U7.26 (CS1), U9.21 (VCC), U9.26 (CS1); also elsewhere on the board

Notes on the sheet:
VIA1 ($7FC0)
VIA2 ($7FA0)

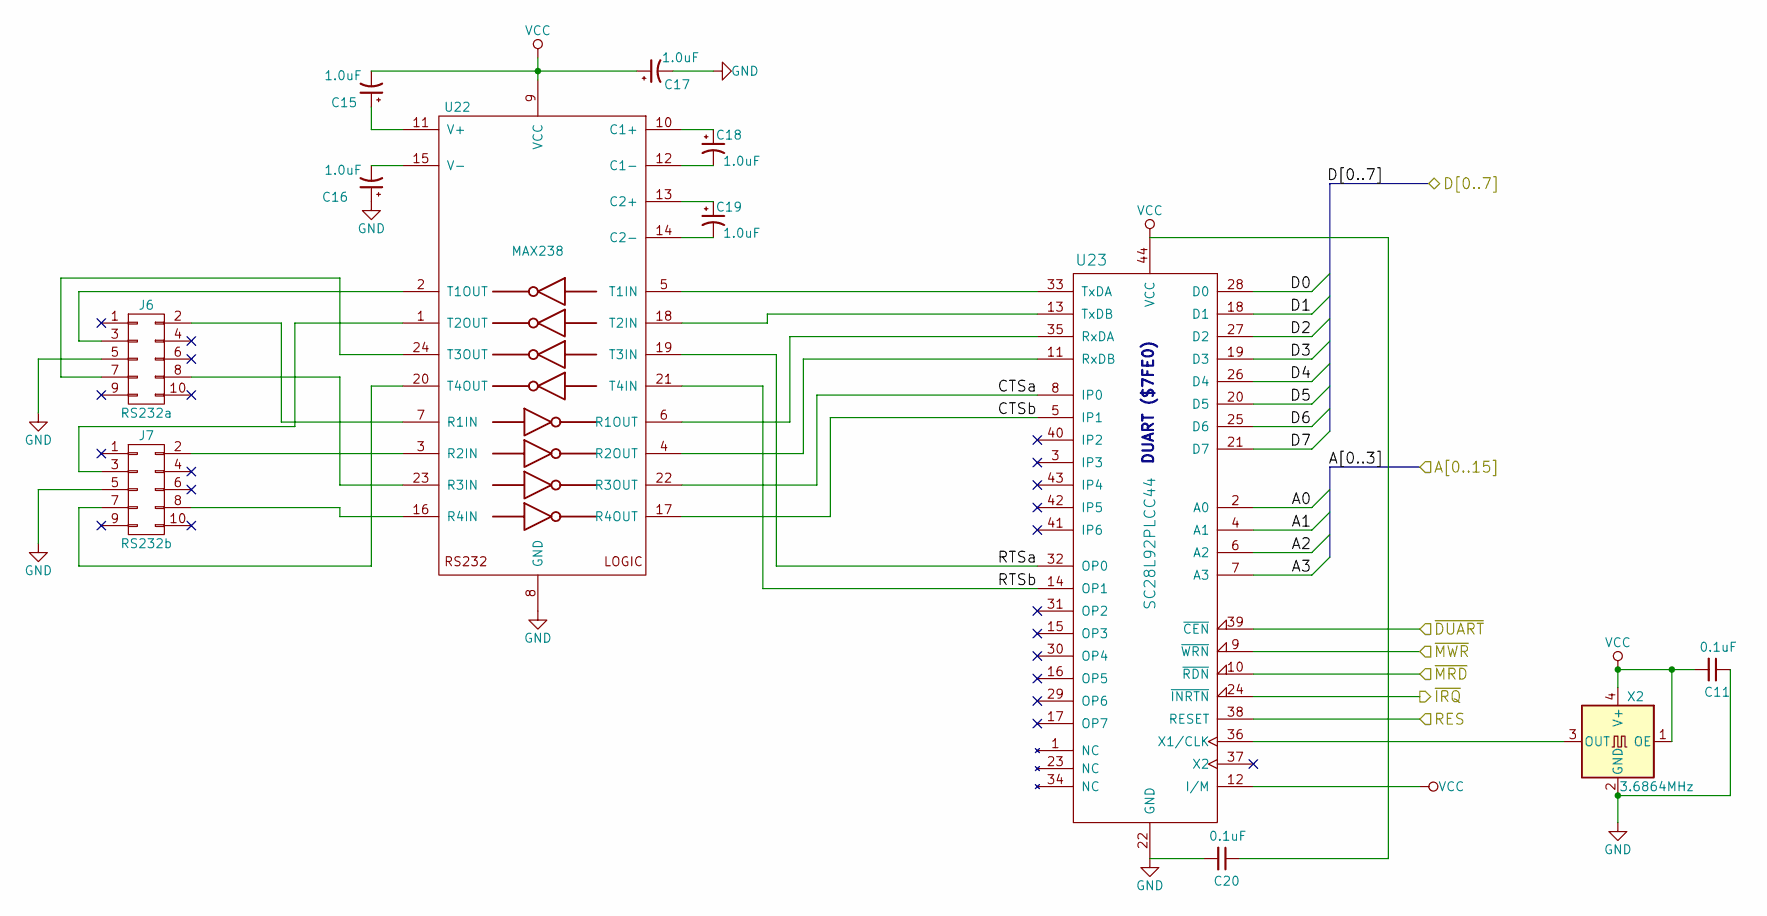
[picture p25: schematic duart_rs232.sch]

Parts:
C11, C20: 0.1uF; C_0805_2012Metric_Pad1.15x1.40mm_HandSolder
C15, C16, C17, C18, C19: 1.0uF; CP_EIA-3528-21_Kemet-B_Pad1.50x2.35mm_HandSolder
J6: RS232a; IDC-Header_2x05_P2.54mm_Vertical
J7: RS232b; IDC-Header_2x05_P2.54mm_Vertical
U22: MAX238; SOIC-24W_7.5x15.4mm_P1.27mm
U23: SC28L92PLCC44; PLCC-44_THT-Socket
X2: 3.6864MHz; Oscillator_SMD_SeikoEpson_SG8002CA-4Pin_7.0x5.0mm

Connections:
/16bit IDE interface/A0: U23.2 (A0); also elsewhere on the board
/16bit IDE interface/A1: U23.4 (A1); also elsewhere on the board
/16bit IDE interface/A2: U23.6 (A2); also elsewhere on the board
/16bit IDE interface/A3: U23.7 (A3); also elsewhere on the board
/16bit IDE interface/D0: U23.28 (D0); also elsewhere on the board
/16bit IDE interface/D1: U23.18 (D1); also elsewhere on the board
/16bit IDE interface/D2: U23.27 (D2); also elsewhere on the board
/16bit IDE interface/D3: U23.19 (D3); also elsewhere on the board
/16bit IDE interface/D4: U23.26 (D4); also elsewhere on the board
/16bit IDE interface/D5: U23.20 (D5); also elsewhere on the board
/16bit IDE interface/D6: U23.25 (D6); also elsewhere on the board
/16bit IDE interface/D7: U23.21 (D7); also elsewhere on the board
/16bit IDE interface/~IRQ: U23.24 (~INRTN); also elsewhere on the board
/Address decoding and support section/RES: U23.38 (RESET); also elsewhere on the board
/Address decoding and support section/~DUART: U23.39 (~CEN); also elsewhere on the board
/Address decoding and support section/~MRD: U23.10 (~RDN); also elsewhere on the board
/Address decoding and support section/~MWR: U23.9 (~WRN); also elsewhere on the board
/DUART and RS232/CTSa: U22.22 (R3OUT), U23.8 (IP0)
/DUART and RS232/CTSb: U22.17 (R4OUT), U23.5 (IP1)
/DUART and RS232/RTSa: U22.19 (T3IN), U23.32 (OP0)
/DUART and RS232/RTSb: U22.21 (T4IN), U23.14 (OP1)
GND: C11.1, C16.1, C17.2, C20.2, J6.5, J7.5, U22.8 (GND), U23.22 (GND), X2.2 (GND); also elsewhere on the board
unnamed: C15.1, U22.11 (V+)
unnamed: C16.2, U22.15 (V-)
unnamed: C18.1, U22.10 (C1+)
unnamed: C18.2, U22.12 (C1-)
unnamed: C19.1, U22.13 (C2+)
unnamed: C19.2, U22.14 (C2-)
unnamed: J6.2, U22.7 (R1IN)
unnamed: J6.3, U22.2 (T1OUT)
unnamed: J6.7, U22.24 (T3OUT)
unnamed: J6.8, U22.23 (R3IN)
unnamed: J7.2, U22.3 (R2IN)
unnamed: J7.3, U22.1 (T2OUT)
unnamed: J7.7, U22.20 (T4OUT)
unnamed: J7.8, U22.16 (R4IN)
unnamed: U22.4 (R2OUT), U23.11 (RxDB)
unnamed: U22.5 (T1IN), U23.33 (TxDA)
unnamed: U22.6 (R1OUT), U23.35 (RxDA)
unnamed: U22.18 (T2IN), U23.13 (TxDB)
unnamed: U23.36 (X1/CLK), X2.3 (OUT)
VCC: C11.2, C15.2, C17.1, C20.1, U22.9 (VCC), U23.12 (I/M), U23.44 (VCC), X2.1 (OE), X2.4 (V+); also elsewhere on the board

Notes on the sheet:
DUART ($7FE0)

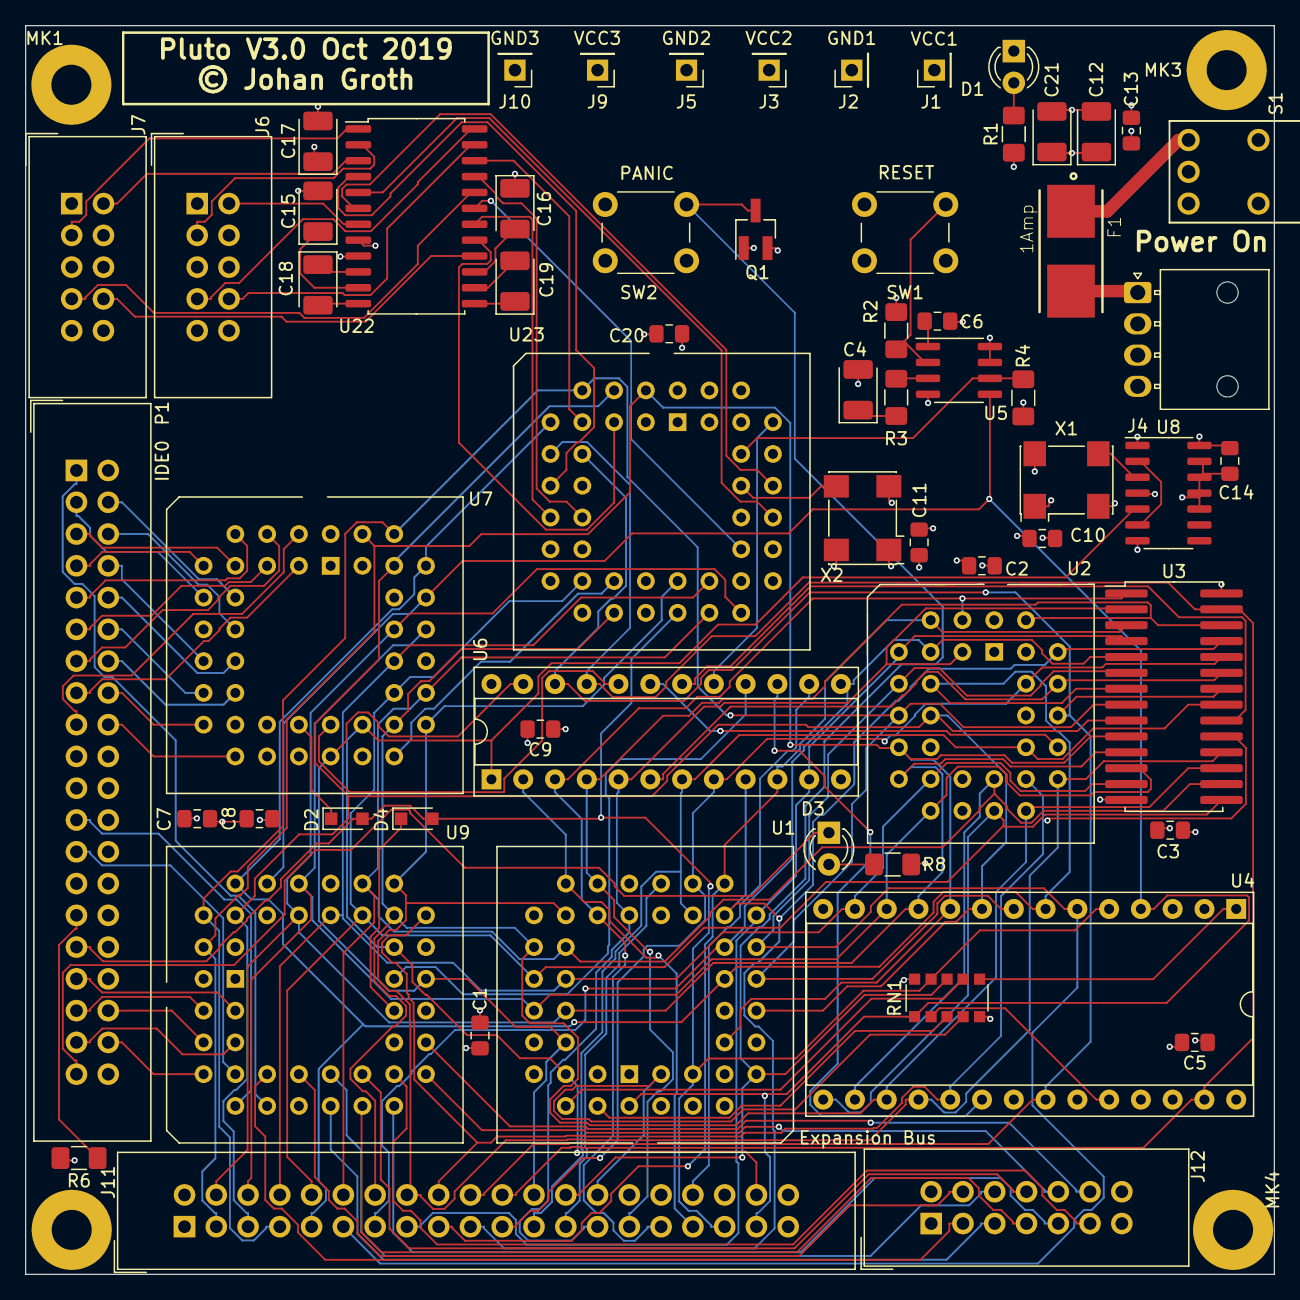
[picture p26: board pluto.kicad_pcb from above]

Board: 4 copper layers, 99.8 x 99.8 mm, 66 parts (0 on the bottom side), 117 nets.
