johangroth/pluto2/SW/sketch_debug/sketch_debug.ino

const unsigned char ADDR[] = {22, 24, 26, 28, 30, 32, 34, 36, 38, 40, 42, 44, 46, 48, 50, 52};
const unsigned char DATA[] = {39, 41, 43, 45, 47, 49, 51, 53};

#define CLOCK 2
#define READ_WRITE 3
#define ROM_SELECT 4
#define RAM_SELECT 5

void setup() {
  for (int i = 0; i < 16; i++) {
    pinMode(ADDR[i], INPUT);
  }
  for (int i = 0; i < 8; i++) {
    pinMode(DATA[i], INPUT);
  }
  
  pinMode(CLOCK, INPUT);
  pinMode(READ_WRITE, INPUT);
  pinMode(ROM_SELECT, INPUT);
  pinMode(RAM_SELECT, INPUT);
  attachInterrupt(digitalPinToInterrupt(CLOCK), onClock, RISING);
  Serial.begin(115200);
}

void onClock() {
  char output[15];
  unsigned int address = 0;
  for (int i = 0; i < 16; i++) {
    int bit = digitalRead(ADDR[i]) ? 1 : 0;
    Serial.print(bit);
    address = (address << 1) + bit;
  }
  Serial.print("    ");
  unsigned int data = 0;
  for (int i = 0; i < 8; i++) {
    int bit = digitalRead(DATA[i]) ? 1 : 0;
    Serial.print(bit);
    data = (data << 1) + bit;
  }
  char rom_sel = digitalRead(ROM_SELECT) ? 's' : 'n';
  char ram_sel = digitalRead(RAM_SELECT) ? 's' : 'n';
  sprintf(output, "    %04x %02x R/W: %c rom: %c ram: %c R/W: %c ", address, data, digitalRead(READ_WRITE) ? 'r' : 'W', rom_sel, ram_sel);
  Serial.println(output);
}

void loop() {
  
}
