johangroth/pluto2/(commit log)

2017-10-27 Initial commit for Pluto 2.0
    [IDE16bit.sch, _saved_cpu_rom_rav.sch, acia_max232.sch, address_decoding_and_support.sch, audio.sch, cpu_rom_ram.sch, cpu_rom_rav.sch, duart_rs232.sch]
2017-12-11 Added CPLD to schematics. Updates rest of schematics to use CPLD
    [IDE16bit.sch, address_decoding_and_support.sch, cpu_rom_ram.sch, duart_rs232.sch, pluto.dsn, pluto.kicad_pcb, pluto.sch, power_and_expansion.sch]
2017-12-11 Move SBC to root.
    [IDE16bit.sch, _saved_cpu_rom_rav.sch, acia_max232.sch, address_decoding_and_support.sch, audio.sch, cpu_rom_ram.sch, cpu_rom_rav.sch, duart_rs232.sch]
2017-12-19 Board ready for production. Added a reset IC that does both low and high logic RES. A power switch and fuse holder is in place. The expansion bus is back, but with an IDC 40 pin connector.
    [IDE16bit.sch, address_decoding_and_support.sch, cpu_rom_ram.sch, duart_rs232.sch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]
2017-12-19 Added datasheets for voltage regulator and power switch. Added footprint for power switch. Added gerbers files for VCC and GND planes.
    [pluto-GND.Cu.gbr, pluto-VCC.Cu.gbr]
2017-12-19 DRC says for pins are not connect. Should that be the case, it can be rectified after production.
    [pluto.kicad_pcb]
2017-12-20 Update of Gerbers files after comments from Newbury Electronics.
    [pluto-B.Cu.gbr, pluto-B.Mask.gbr, pluto-B.SilkS.gbr, pluto-Edge.Cuts.gbr, pluto-F.Cu.gbr, pluto-F.SilkS.gbr, pluto-GND.Cu.gbr, pluto-VCC.Cu.gbr]
2017-12-22 Final touches for PCB train web service.
    [IDE16bit.sch, address_decoding_and_support.sch, cpu_rom_ram.sch, duart_rs232.sch, pluto.sch, power_and_expansion.sch, via_rtc.sch]
2017-12-24 Address decoding done.
    [pluto.sdf]
2017-12-26 Fixed bug in address decoding (found in simulation).
    [pluto.sdf]
2018-02-01 Beginning to link ABEL with schematics.
    [address_decoding.sch, ide.sch, pluto.sdf]
2018-02-13 Added full address decoding as a schematic. DRC fails.
    [ide.sch]
2018-02-19 CPLD schematic updates.
2018-02-19 CPLD schematic changes.
    [ide.sch]
2018-06-30 Added PlutoDos so support for NXP SC28L92 can be added.
    [ide.sch, via_rtc.sch]
2018-06-30 Preparing BIOS for new serial communication device, SC28L92.
2018-08-16 Preparation for using SC28L92 DUART as a communication device.
2018-08-23 Added send/receive code in ISR. Doesn't handle TxFIFOA full condition.
    [duart_sc28l92.asm]
2018-09-30 Test code. Should blink a LED connected to VIA PB0 but doesn't.
    [bios.asm, duart_sc28l92.asm, main.asm, rtc.asm, via.asm]
2018-11-15 Via1 io $7fa0 Via2 io $7fc0 Fix bug in delay routine. Use temp1 in monitor instead of tmp used in ide routines.
    [bios.asm, main.asm, monitor.asm, via.asm]
2019-05-05 Small changes to schematics
    [IDE16bit.sch, address_decoding_and_support.sch, cpu_rom_ram.sch, duart_rs232.sch, pluto.sch, power_and_expansion.sch, via_rtc.sch]
2019-07-19 Various changes
    [IDE16bit-2018-11-16-18-17-23.sch, address_decoding_and_support-2018-11-16-18-17-23.sch, cpu_rom_ram-2018-11-16-18-17-23.sch, duart_rs232-2018-11-16-18-17-23.sch, pluto-2018-11-16-18-17-23.sch, pluto.kicad_pcb, power_and_expansion-2018-11-16-18-17-23.sch, via_rtc-2018-11-16-18-17-23.sch]
2019-08-05 Preparation for Pluto v3.0
    [IDE16bit.sch, address_decoding.sch, address_decoding_and_support.sch, cpu_rom_ram.sch, duart_rs232.sch, ide.sch, pluto.dsn, pluto.kicad_pcb]
2019-08-05 A better layout of PCB.
    [IDE16bit.sch, address_decoding_and_support.sch, duart_rs232.sch, pluto.dsn, pluto.kicad_pcb, power_and_expansion.sch, via_rtc.sch]
2019-08-06 Autorouting of Pluto v3.0 complete. Fixed VCC/GND and IDE-A2(!)
    [address_decoding_and_support.sch, pluto.dsn, pluto.kicad_pcb]
2019-09-07 Converting to SMD of almost all components.
    [IDE16bit.sch, address_decoding_and_support.sch, cpu_rom_ram.sch, duart_rs232.sch, pluto.kicad_pcb, power_and_expansion.sch, via_rtc.sch]
2019-09-19 New PCB layout is taking shape.
    [IDE16bit.sch, address_decoding_and_support.sch, cpu_rom_ram.sch, duart_rs232.sch, pluto.kicad_pcb, via_rtc.sch]
2019-09-19 Added new datasheet for SMD resistor bus array.
2019-09-20 Added datasheets for 7-seg LED Kingbright displays.
    [pluto.kicad_pcb]
2019-09-25 Added Arduino sketch to debug pluto. Added IDE spec.
2019-09-29 Layout of PCB continues.
    [pluto.kicad_pcb, power_and_expansion.sch]
2019-09-30 Added de-coupling cap to 74hc74. Rearranged PCB a bit.
    [address_decoding_and_support.sch, cpu_rom_ram.sch, pluto.kicad_pcb, power_and_expansion.sch]
2019-10-20 Pluto2 V3 PCB routed and finished. Removed all Pluto2 V2 Gerber files. Add GAL files for address and IO decoding.
    [IDE16bit.sch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]
2019-11-03 Added clock generator using an Arduino Nano. Gerbers made and sent to manufacturer. Some assembler testing bread board setup
    [pluto-B_Cu.gbr, pluto-B_Mask.gbr, pluto-B_SilkS.gbr, pluto-Edge_Cuts.gbr, pluto-F_Cu.gbr, pluto-F_Mask.gbr, pluto-F_SilkS.gbr, pluto-GND_Cu.gbr]
2019-11-14 Directory restructoring
    [IDE16bit-2018-11-16-18-17-23.sch, IDE16bit.sch, _saved_cpu_rom_rav.sch, acia_max232.sch, address_decoding_and_support-2018-11-16-18-17-23.sch, address_decoding_and_support.sch, audio.sch, cpu_rom_ram-2018-11-16-18-17-23.sch]
2019-11-16 Sped up blinking of LED.
2020-03-08 Fixing setup of SC28L92. Still WIP.
    [bios.asm, duart_sc28l92.asm]
2020-03-09 Disable power down. Align init code to force a page break when reading the init table.
    [IDE16bit.sch, address_decoding_and_support.sch, cpu_rom_ram.sch, duart_rs232.sch, pluto.sch, power_and_expansion.sch, via_rtc.sch]
2020-05-09 New version of SC28L92 initialisation. Still WIP (ie, doesn't work)
    [bios.asm, duart_sc28l92.asm]
2020-05-09 KiCad added this file.
