johangroth/pluto2/(notices)

Notices in the files:
HW/pluto.kicad_pcb:
© Johan Groth
